hello/morpheus-board-middle/README.md

Hello Morpheus Middle board Repository
===
