hello/morpheus-board-middle/Morpheus_middle/54mm Board.DXF

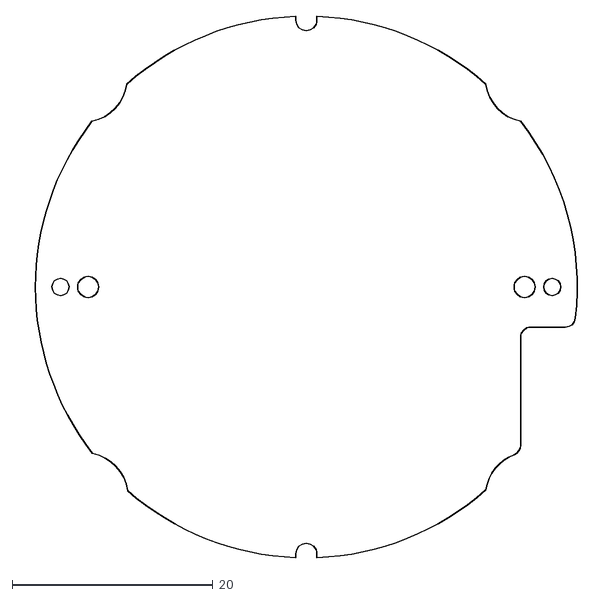
[picture p1: CAD file, 2014-11-20]
Morpheus_middle/54mm Board.DXF
56.5 x 54.0
