hello/morpheus-board-middle/Morpheus_middle/905-00004.DXF

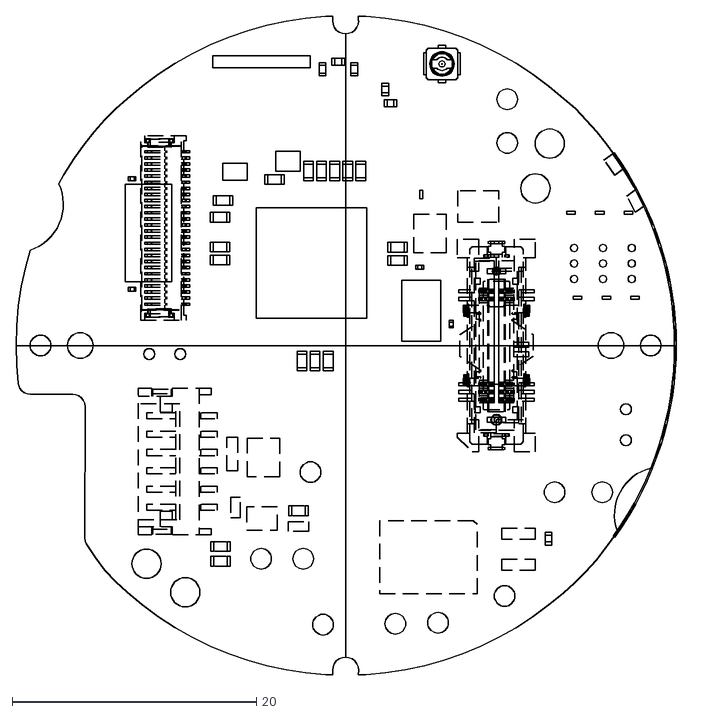
[picture p2: CAD file, 2014-11-20]
Morpheus_middle/905-00004.DXF
55.8 x 54.0
