hello/morpheus-board-middle/(list of files, cad)

Other CAD files:
Morpheus_middle/905-00004-04-DVTd.DWG
Morpheus_middle/Morpheus_middle.DWG
