hello/morpheus-board-middle/Release Files/Morpheus_middle_PVT_release_candidate_123014.PDF

IF CC3200 is changed to operate off of wide input voltage range,
the 1V8 tie needs to change to VBAT

to Program Boot Flash

Cross Connect UART
(To Nordic)
Analog Input from Dust Sensor

Nordic SPI Chip Select

interrupt from Nordic
interrupt from mid-board RTC

Digital Output to Dust Sensor
I2C Sensors
from I2S Codec
Nordic SPI CLK

CC_3200_PIN18
pin 18 is not usable as GPIO

WLAN_XTALM

TITLE M4F_MCU | REV DVT

DaTE | DRaWN BY D. Fusi | SHEET 1 OF 7


to the bottom board H1

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

OE is tied high. Provisions have been added to
tie it to nRESET in case the part doesn't come
up properly (small note in the datasheet p.2)


Power scheme only for reference

VIN_IO2 54

VDD_ANA2 | VDD_ANA2 47 VDD_ANA1 48

VDD_RAM | VDD_PA_IN VDD_RAM 49 VDD_DCDC_ANA | 33

VDD_PLL 24

VIN_DCDC_DIG 44

All filtering caps as per TI's recomendations

Route ground traces for C15, C16 and C17 to single vias on the EPAD. Isolate them from pours in inner layers


level shifter from 4V to 1.8V

Connector for Sharp dust sensor GP2Y1010AU0F

JST_S6B-ZR-SM4A-TF (LF)(SN)(P)

As on the GP2Y1010 datasheet


TI wants 17 and R18 to be installed but we've always been good without

Datasheet is unclear, so for now we pull reset high and WP low


R9 and R26 will be inductors if needed. C46 and C47 DNP for now

Murata 0201 GJM0335C1ER20WB01
Murata 0402 GJM1555C1H100GB01D
Murata 0402 LQP15MN1N0B02
GJM series is better than GRM for RF


CLK needs a dedicated level shifter beacuse of speed

CMD and DAT shifter on dedicated level shifter

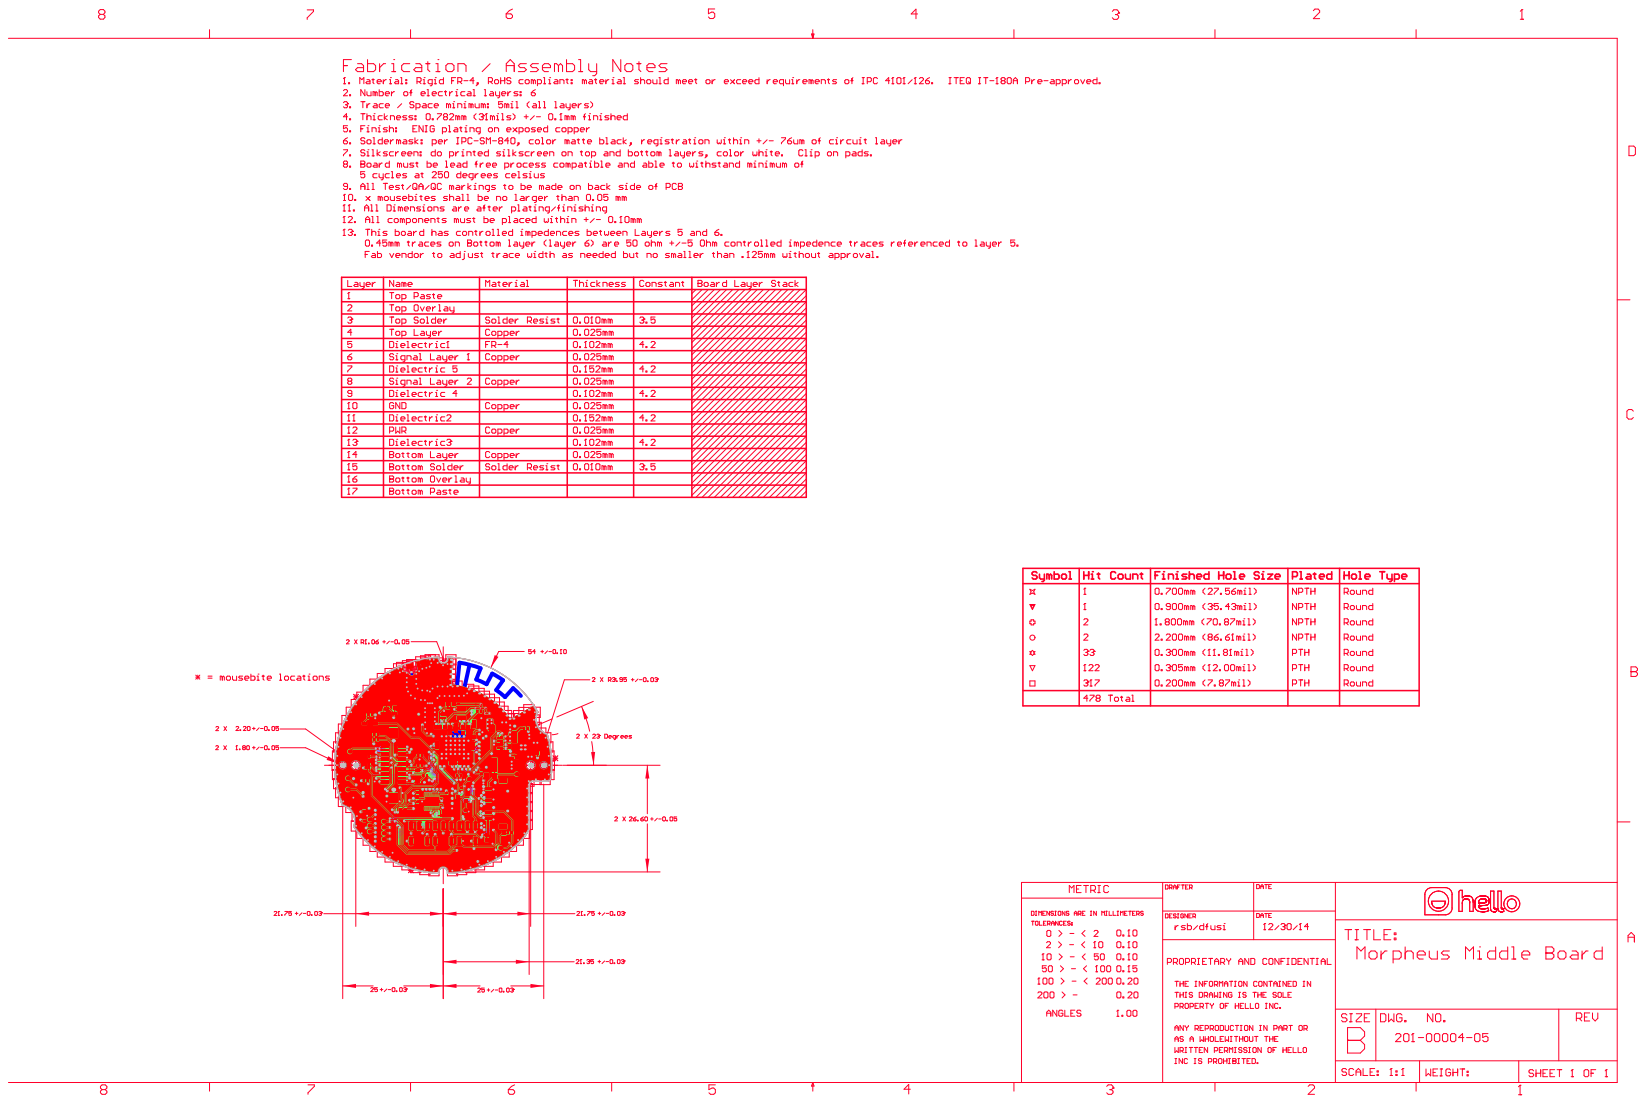
[picture p13: page 8]

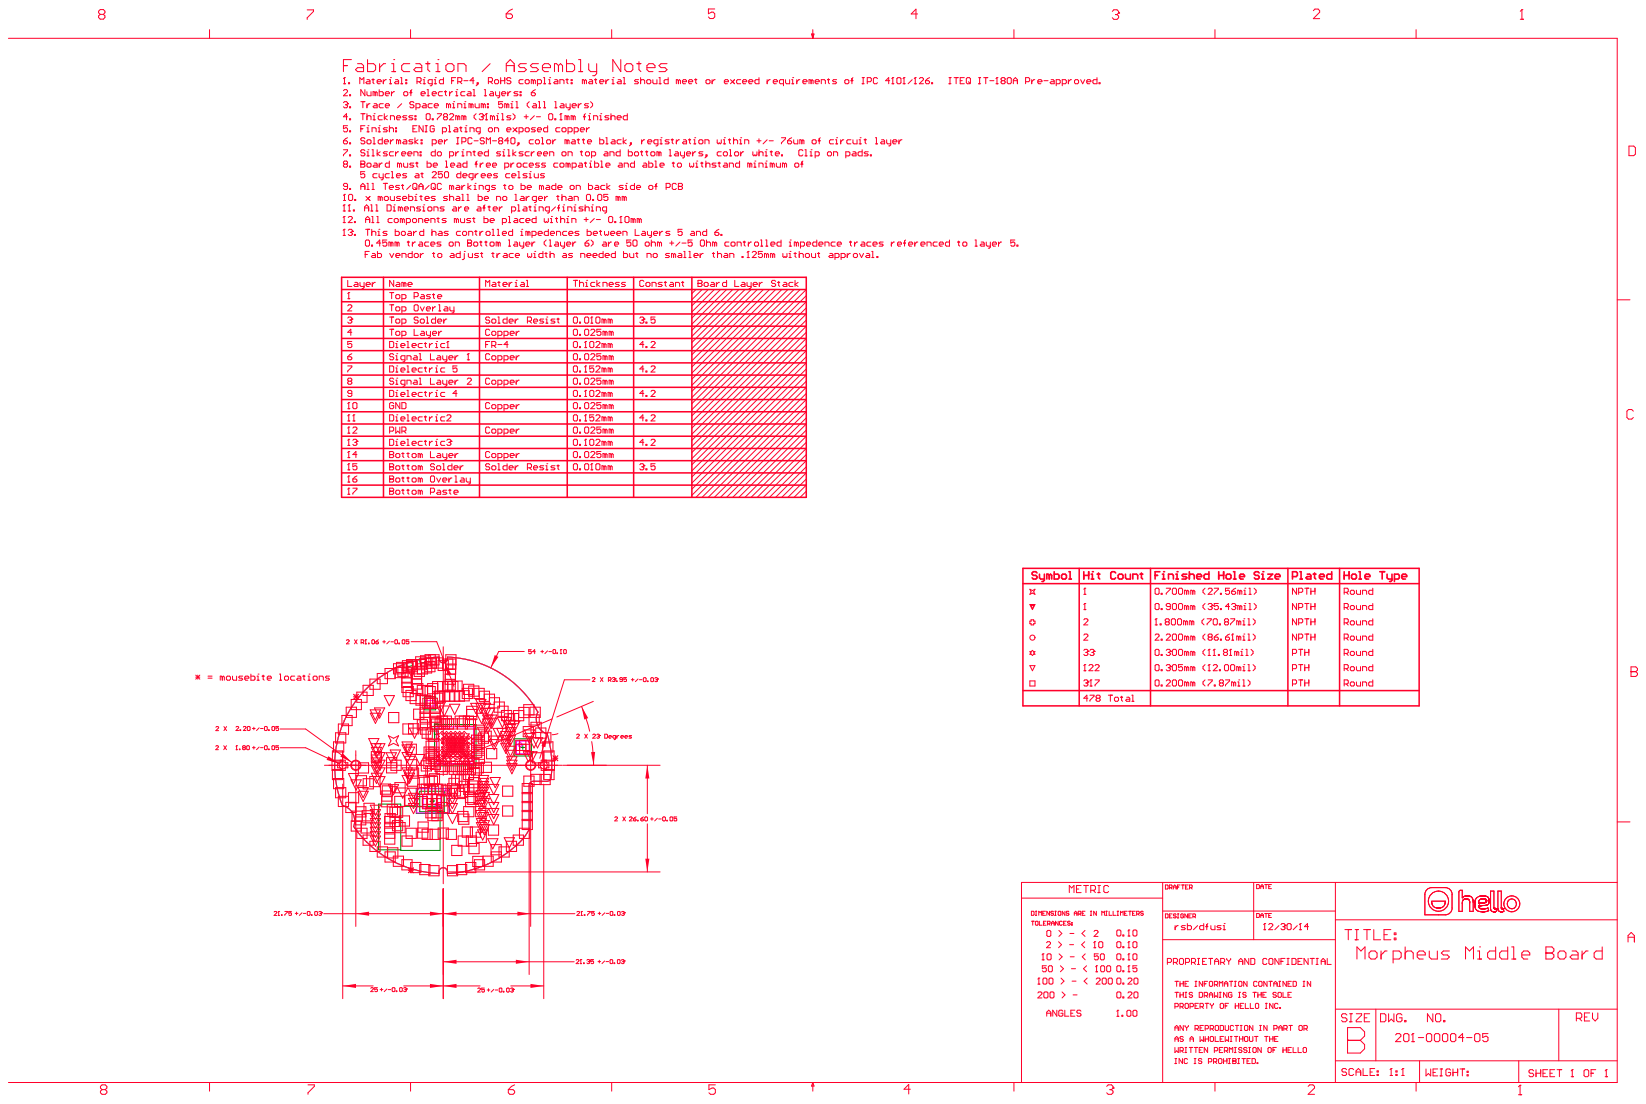
[picture p14: page 9]

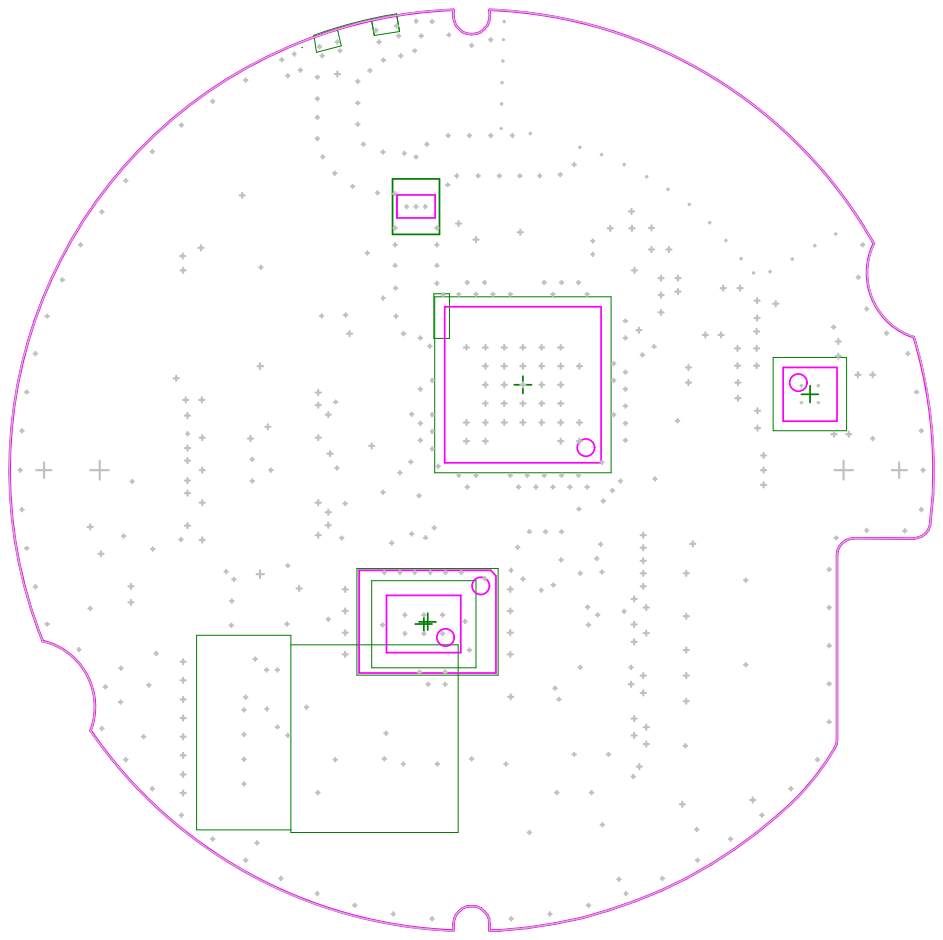
[picture p15: page 10]
