hello/morpheus-board-middle/Morpheus_middle/Morpheus_middle.PDF

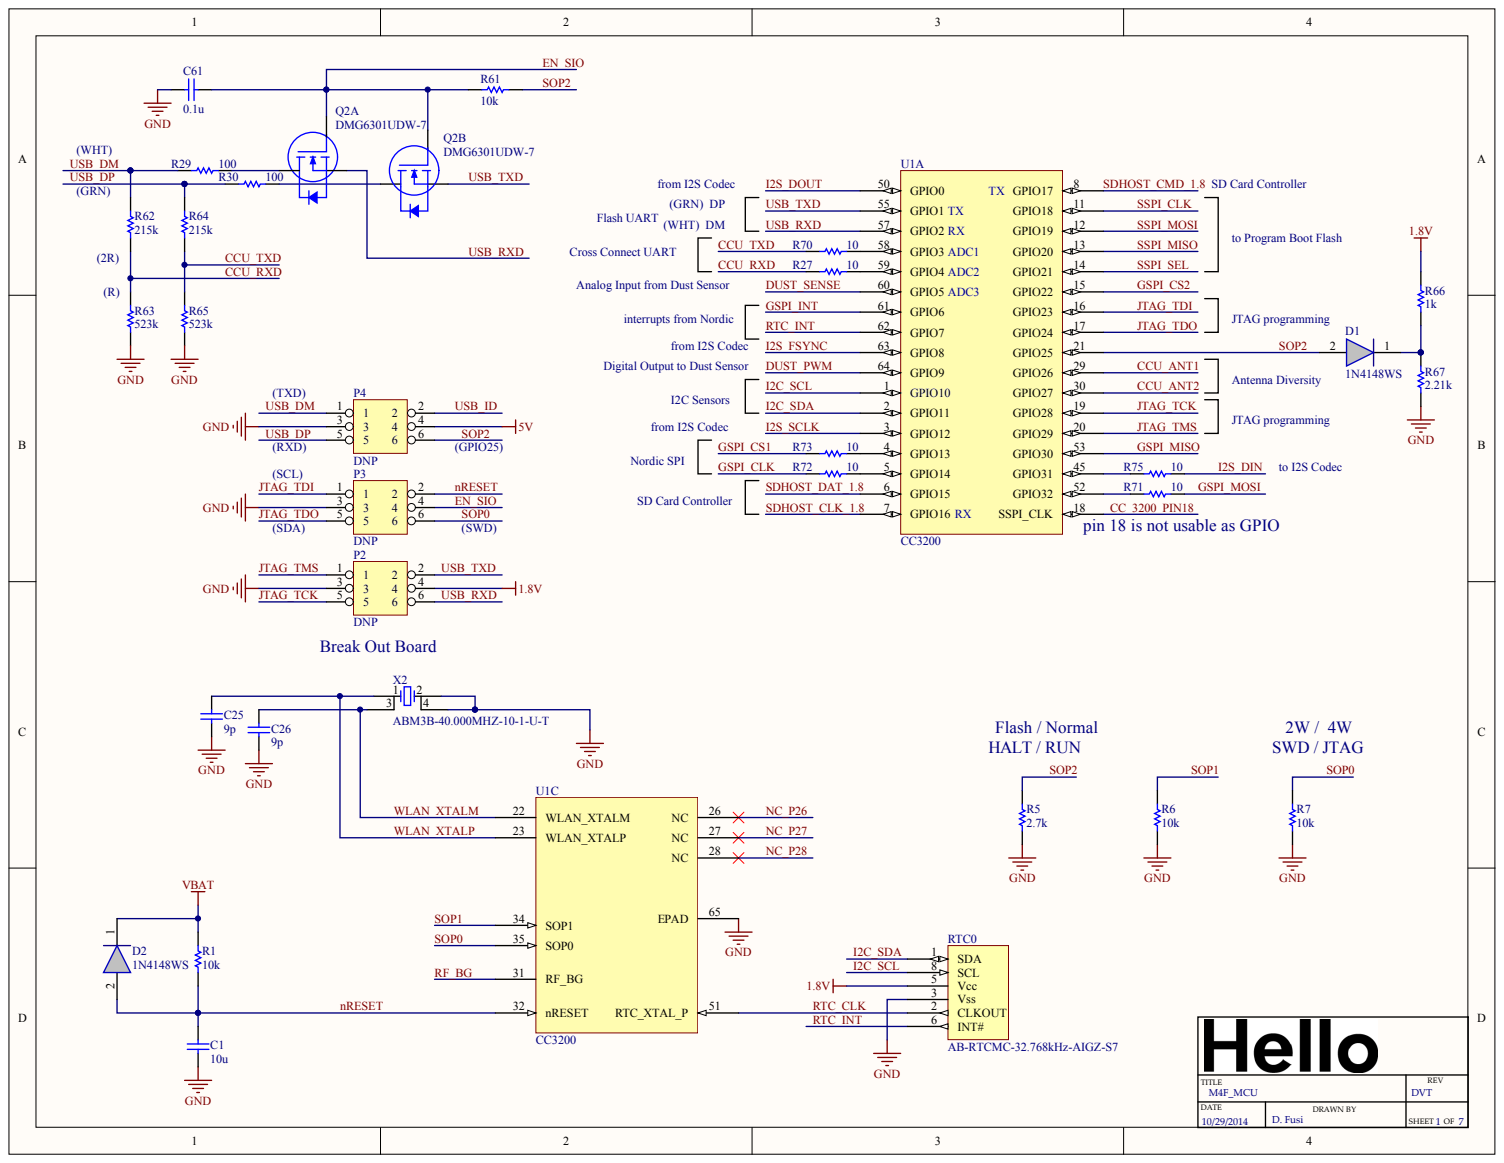
[picture p27: page 1]

to Program Boot Flash

Analog Input from Dust Sensor

Digital Output to Dust Sensor

CC_3200_PIN18
pin 18 is not usable as GPIO

WLAN_XTALM

TITLE M4F_MCU | REV DVT

DATE | DRAWN BY D. Fusi | SHEET 1 OF 7

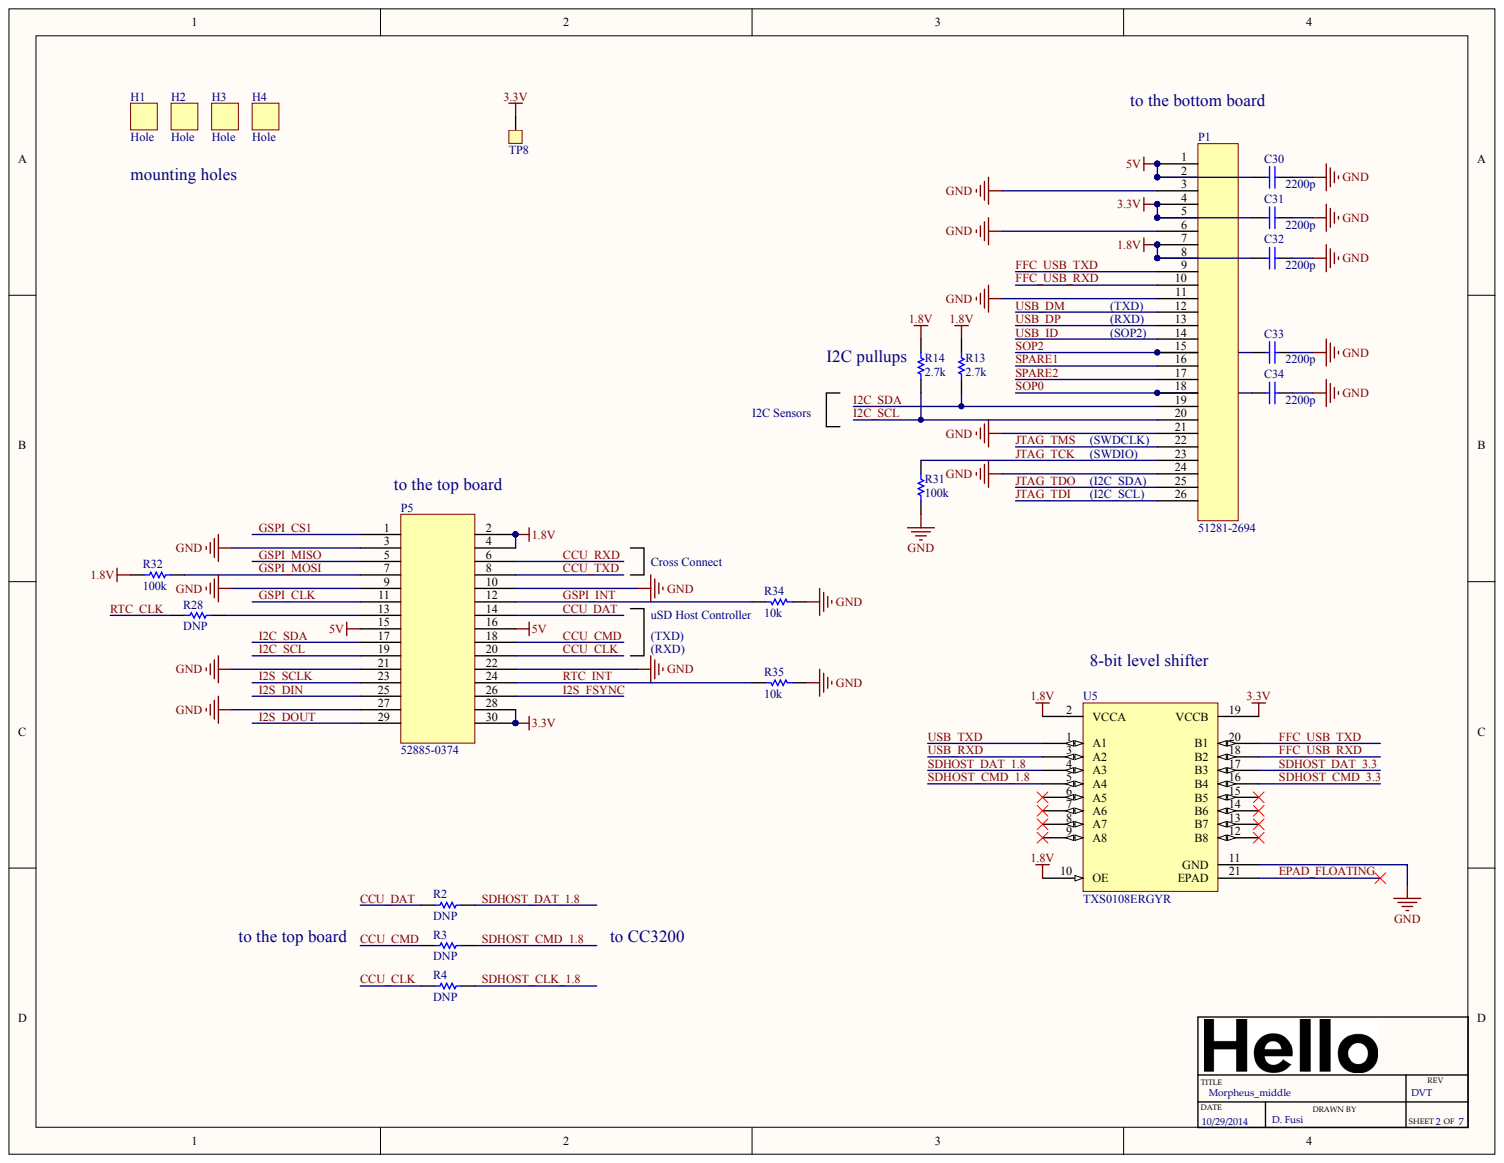
[picture p28: page 2]

to the bottom board H1

to the top board

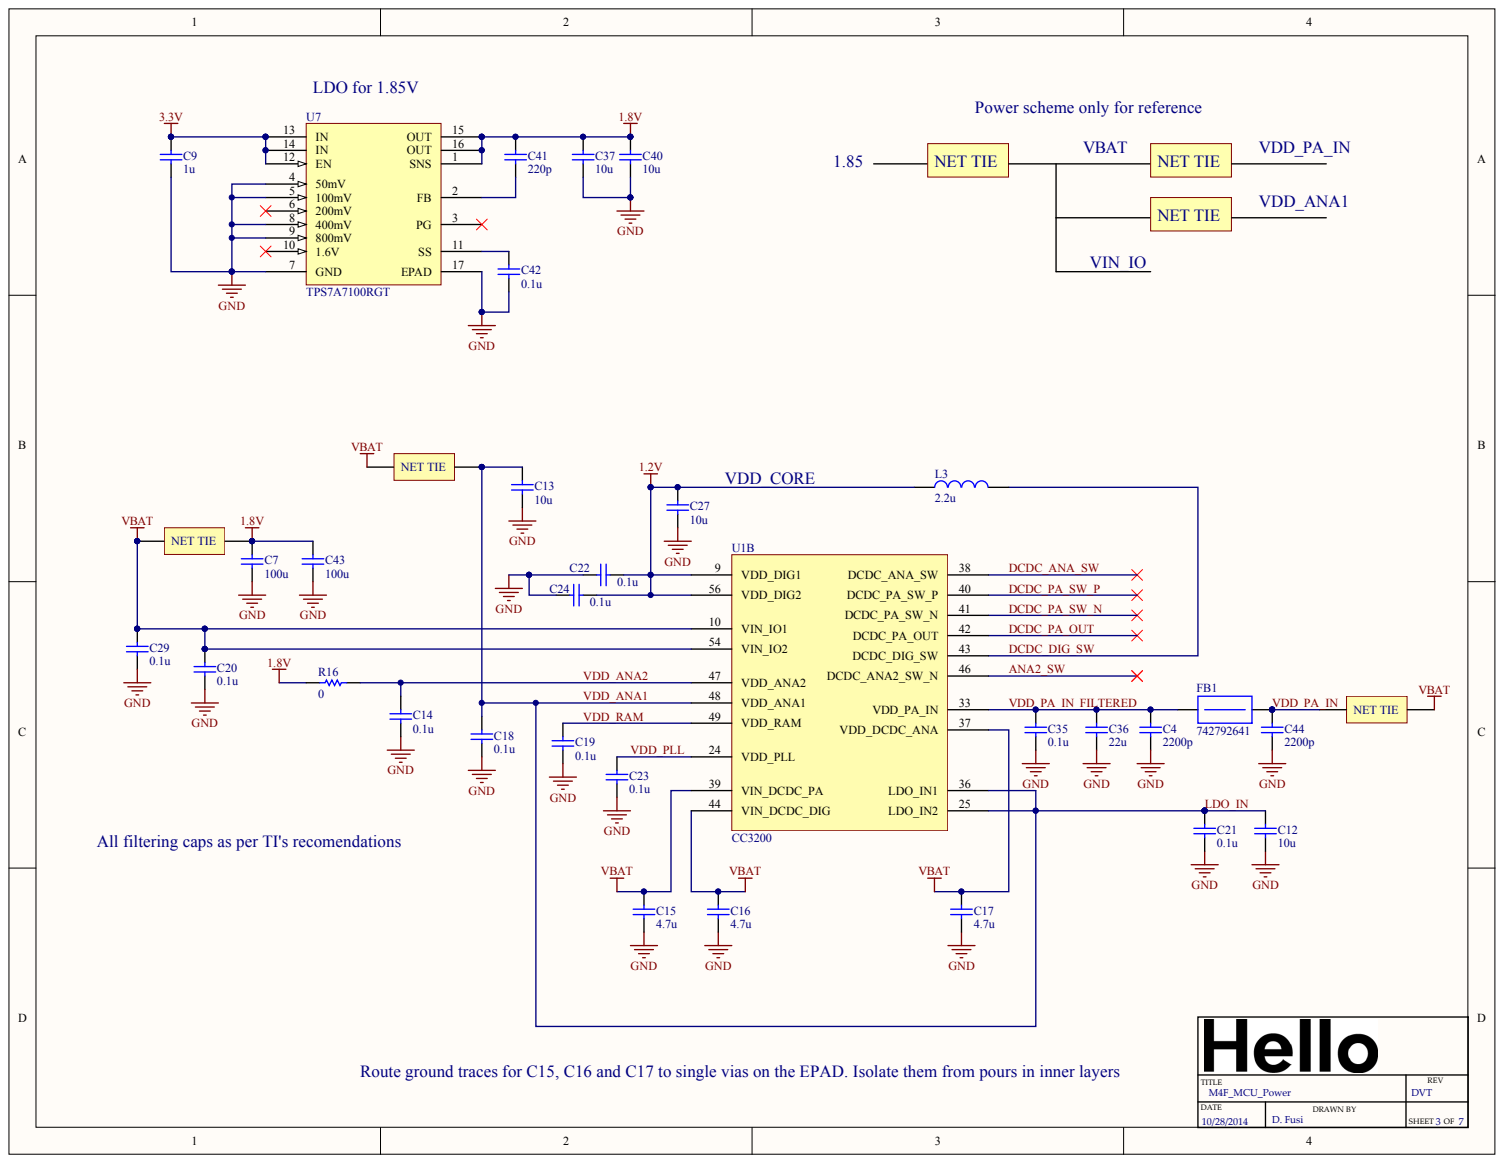
[picture p29: page 3]

Power scheme only for reference

VIN_IO2 54

VDD_ANA2 | VDD_ANA2 47 VDD_ANA1 48

VDD_RAM | VDD_PA_IN VDD_RAM 49 VDD_DCDC_ANA | 33

VDD_PLL 24

VIN_DCDC_DIG 44

All filtering caps as per TI's recomendations

Route ground traces for C15, C16 and C17 to single vias on the EPAD. Isolate them from pours in inner layers

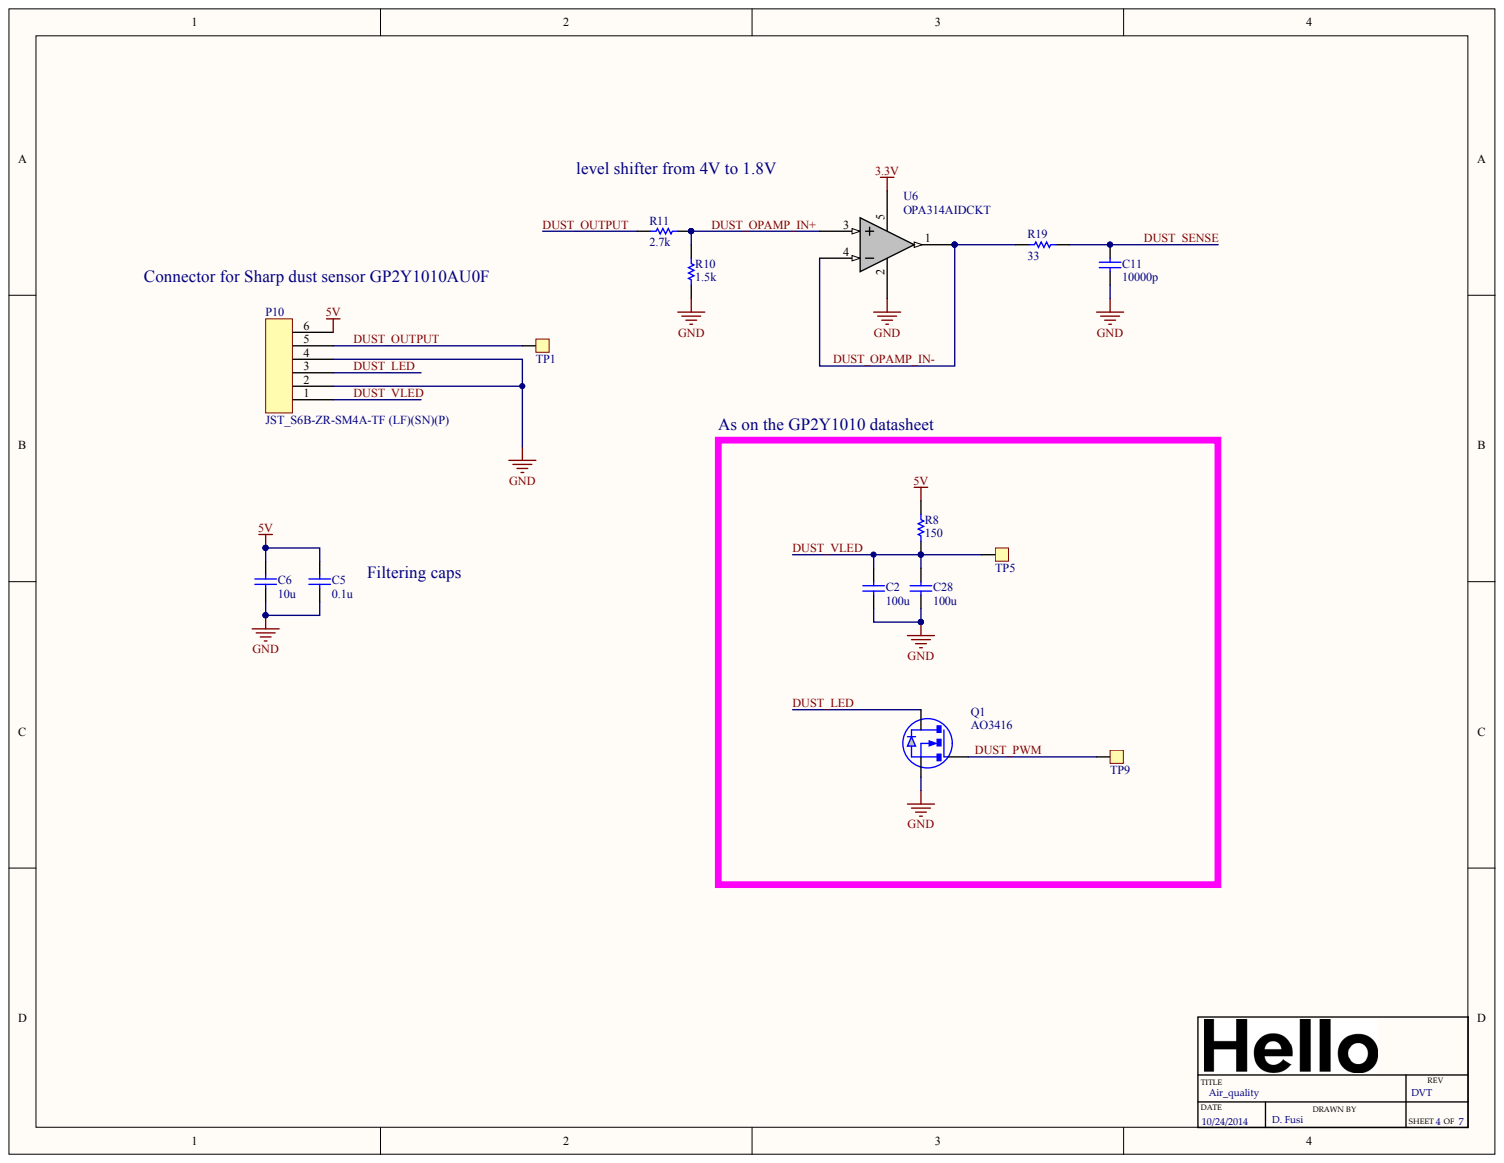
[picture p30: page 4]

level shifter from 4V to 1.8V

Connector for Sharp dust sensor GP2Y1010AU0F

JST_S6B-ZR-SM4A-TF (LF)(SN)(P)

As on the GP2Y1010 datasheet

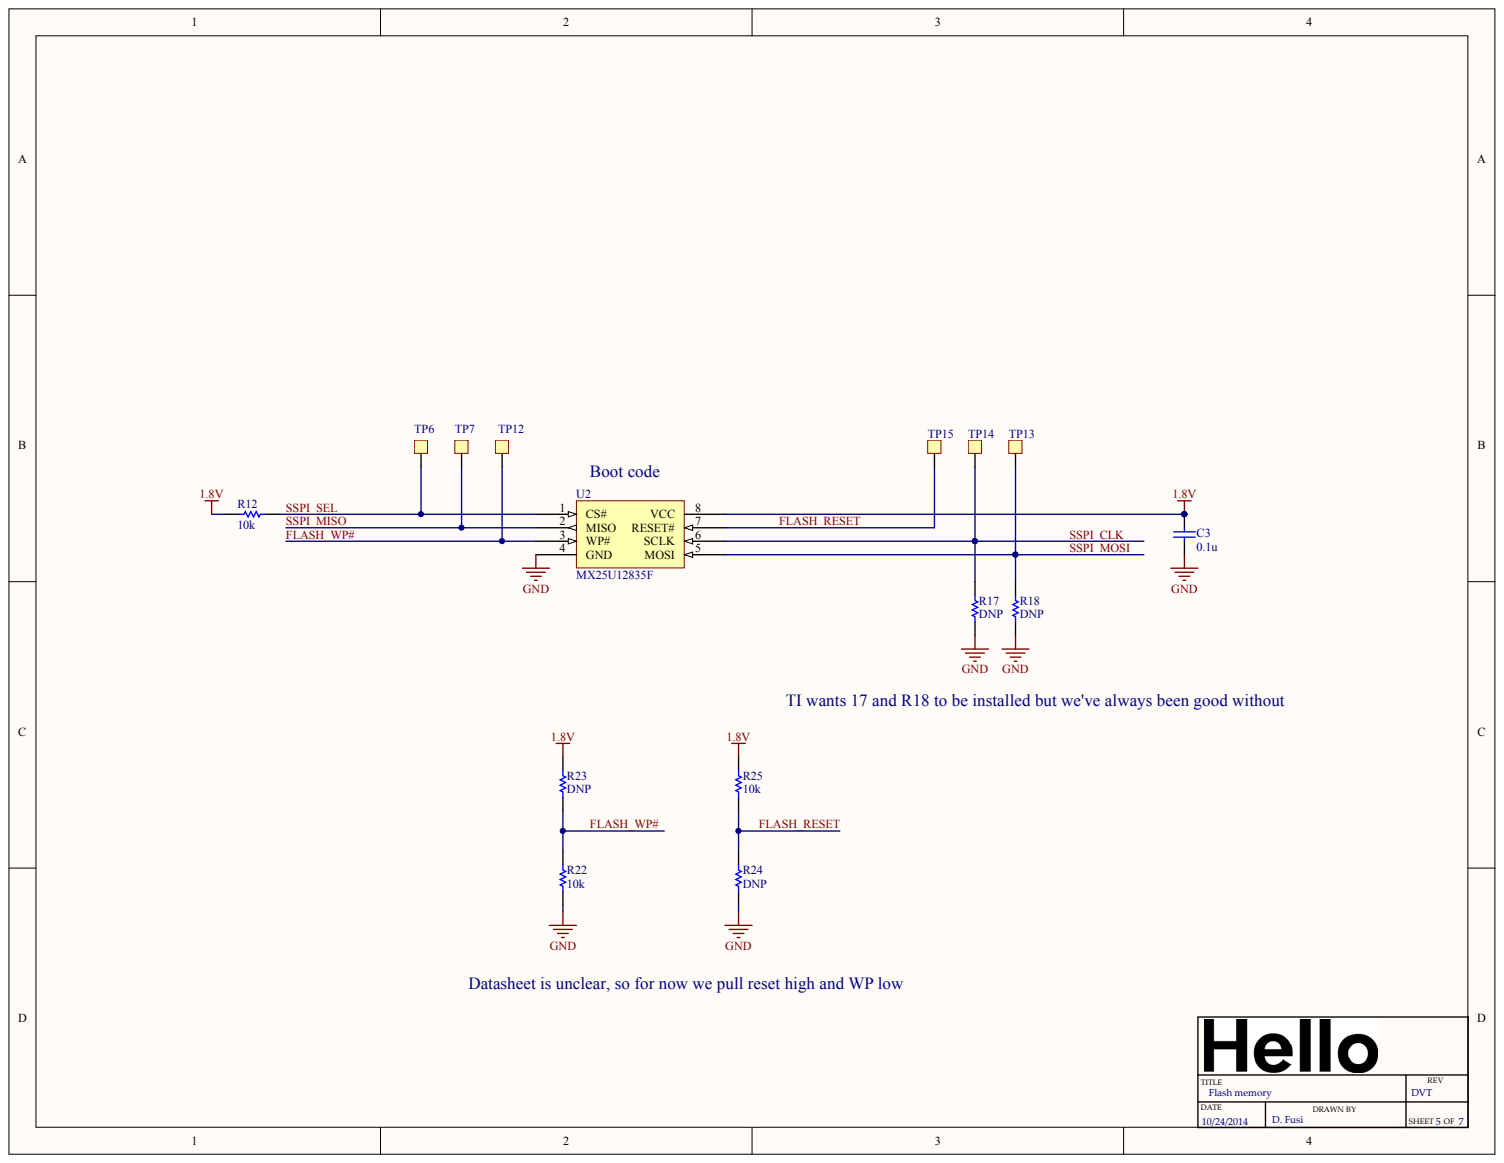
[picture p31: page 5]

TI wants 17 and R18 to be installed but we've always been good without

Datasheet is unclear, so for now we pull reset high and WP low

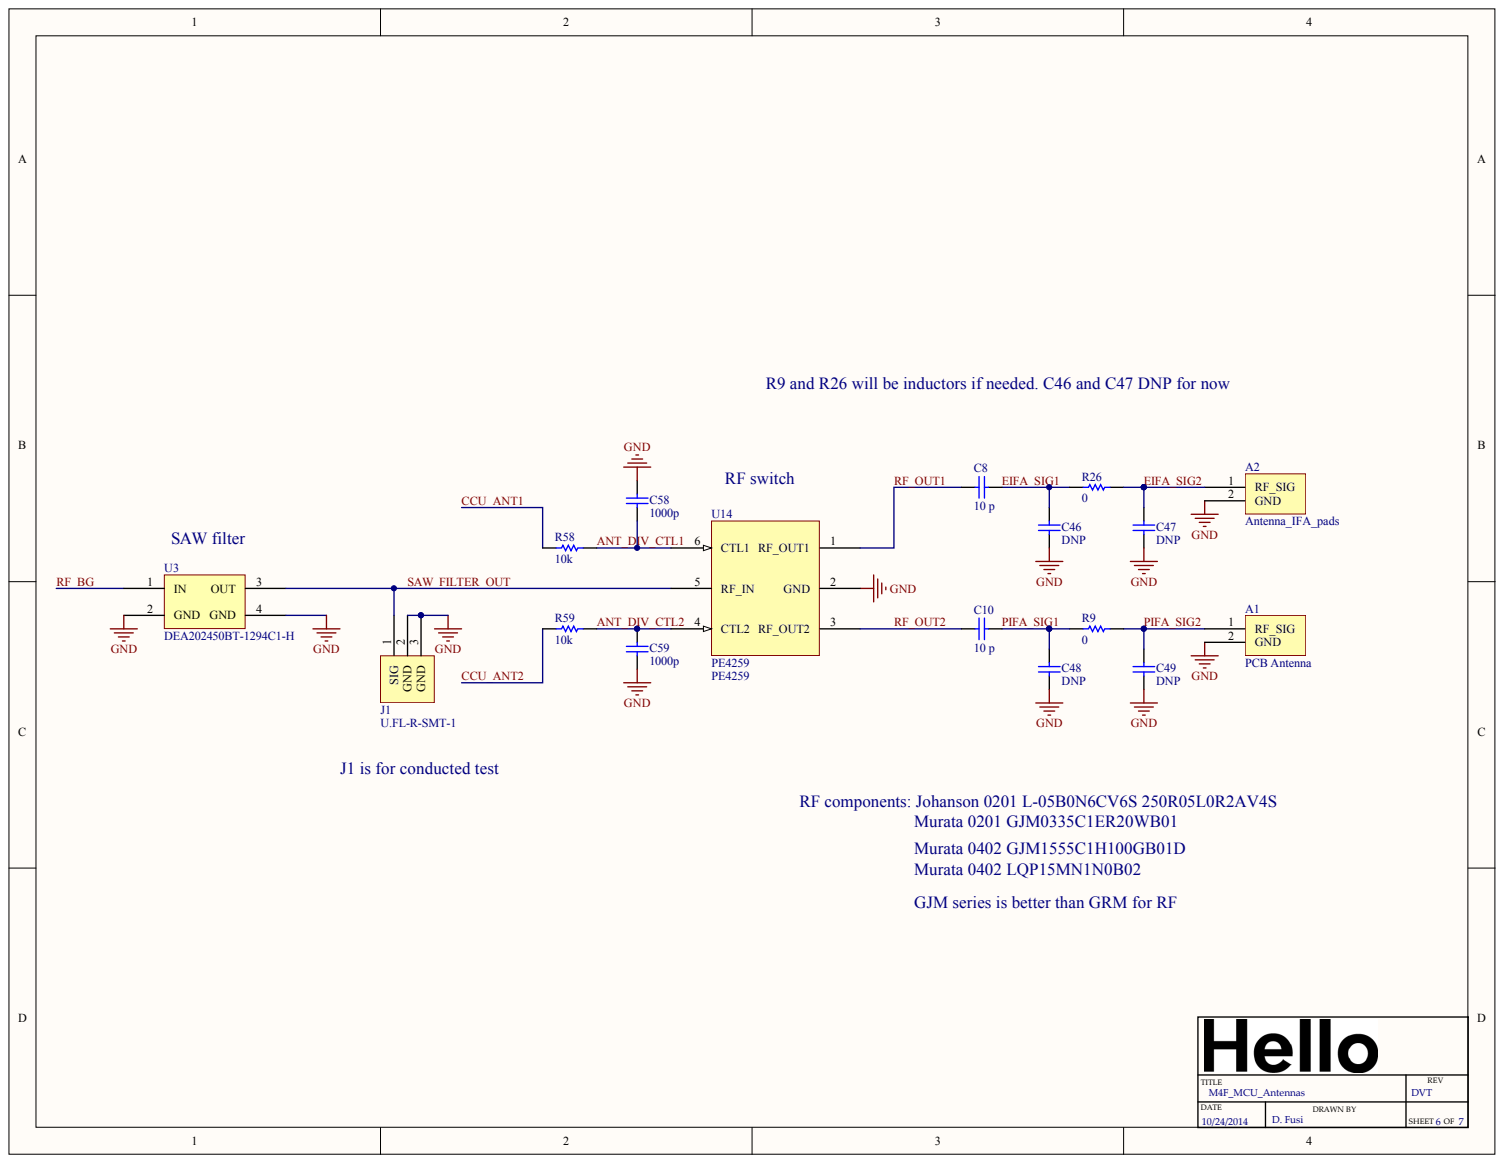
[picture p32: page 6]

R9 and R26 will be inductors if needed. C46 and C47 DNP for now

J1 is for conducted test

GJM series is better than GRM for RF

TITLE M4F_MCU_A nten nas

D ATE | DRAWN BY D . Fusi | S HEET 6 OF


CLK needs a dedicated level shifter beacuse of speed

CMD and DAT shifter on dedicated level shifter
