hello/morpheus-board-middle/Morpheus_middle/Morpheus_middle_DVT_release_candidate_111714.PDF

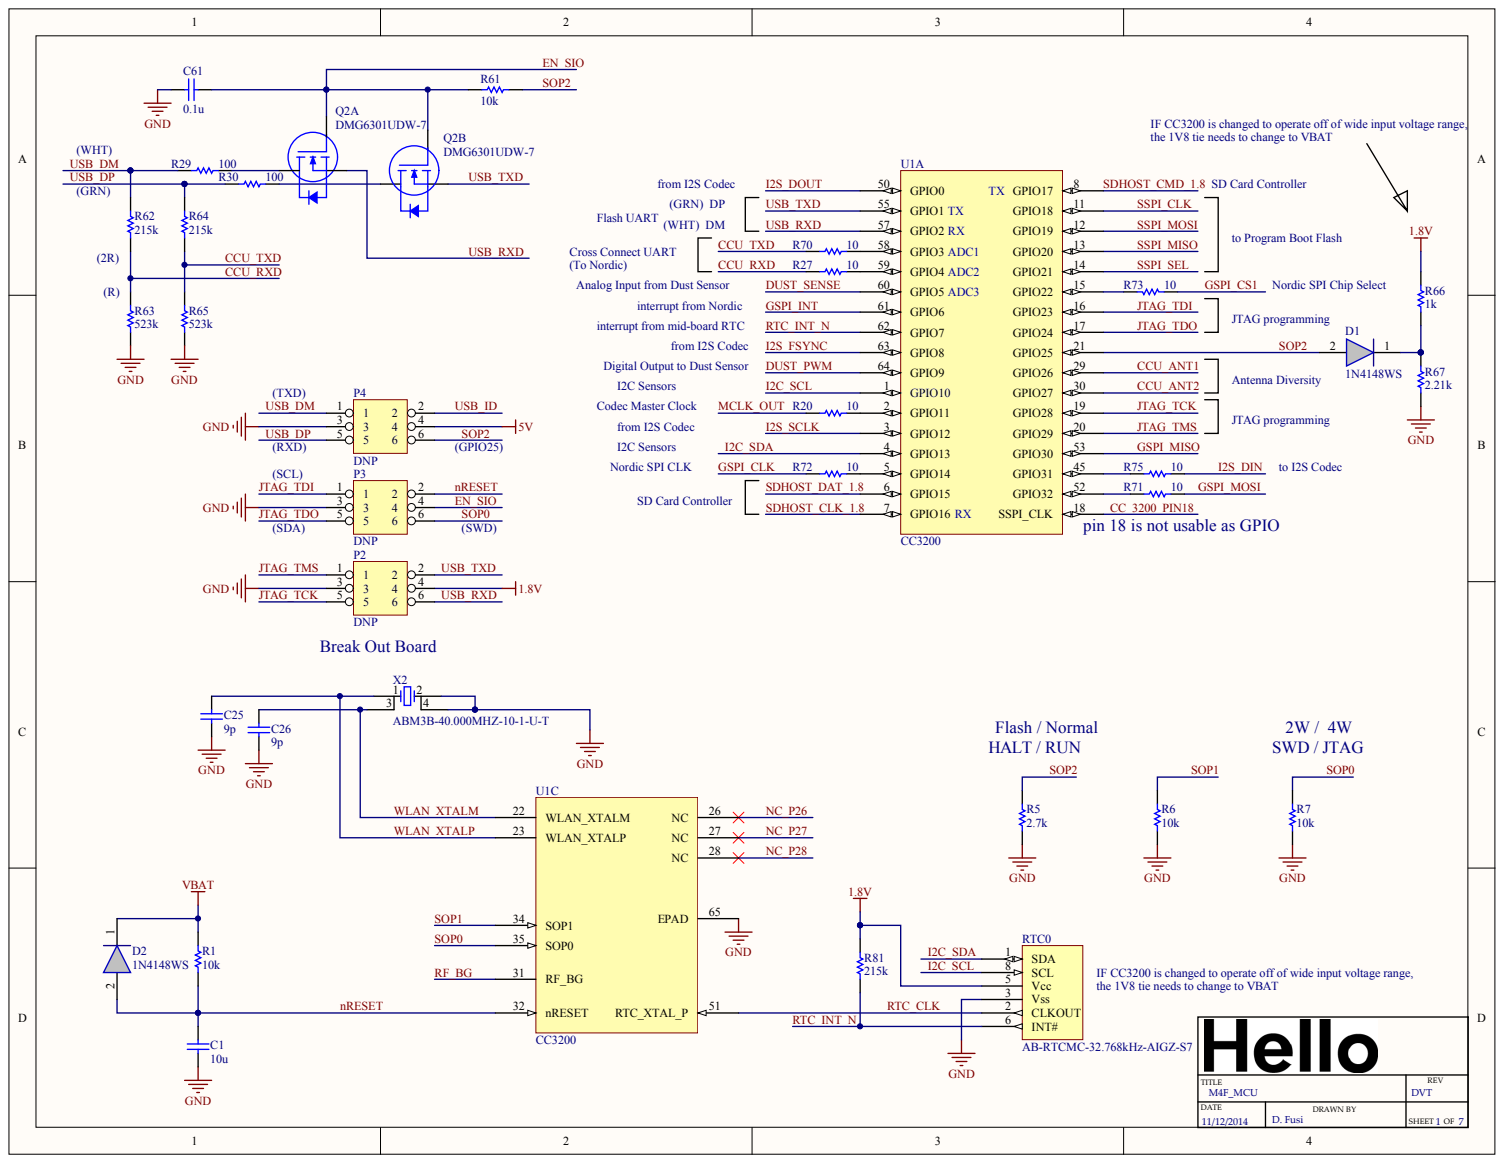
[picture p33: page 1]

IF CC3200 is changed to operate off of wide input voltage range,
the 1V8 tie needs to change to VBAT

Cross Connect UART
(To Nordic)
Analog Input from Dust Sensor

to Program Boot Flash

Nordic SPI Chip Select

interrupt from mid-board RTC

Digital Output to Dust Sensor
I2C Sensors
from I2S Codec
Nordic SPI CLK

CC_3200_PIN18
pin 18 is not usable as GPIO

WLAN_XTALM

TITLE M4F_MCU | REV DVT

DATE | DRAWN BY D. Fusi | SHEET 1 OF 7

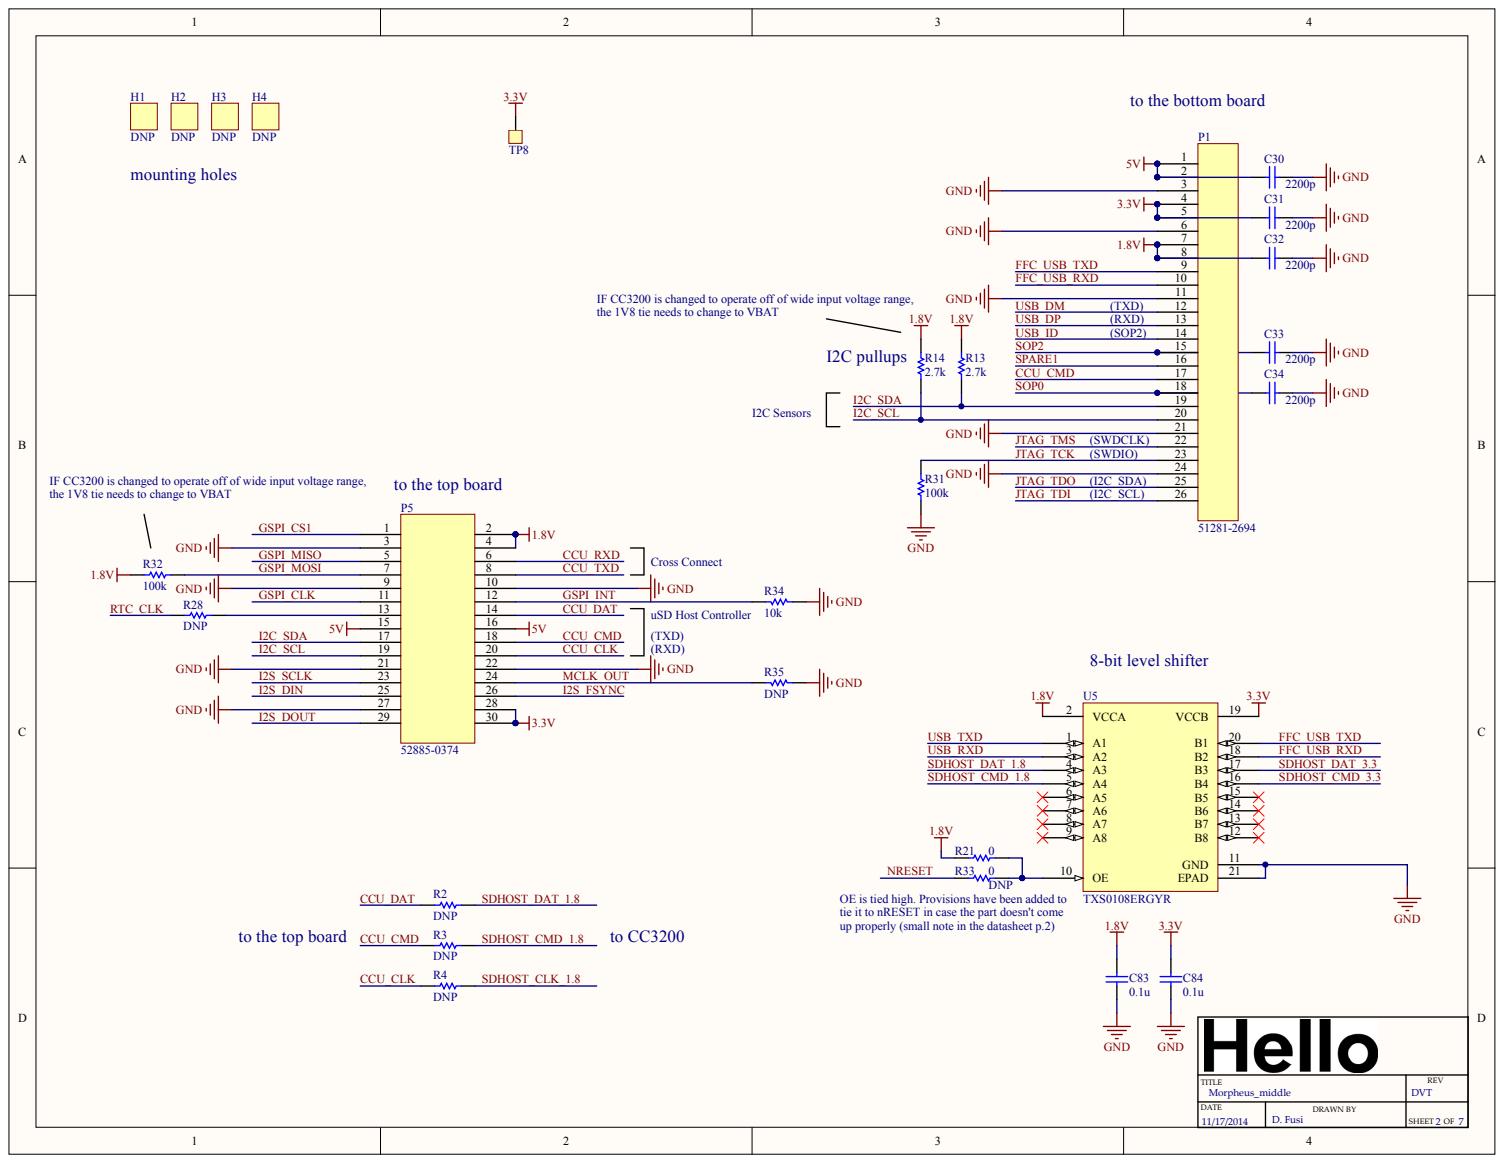
[picture p34: page 2]

to the bottom board H1

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

to the top board

OE is tied high. Provisions have been added to
tie it to nRESET in case the part doesn't come
up properly (small note in the datasheet p.2)

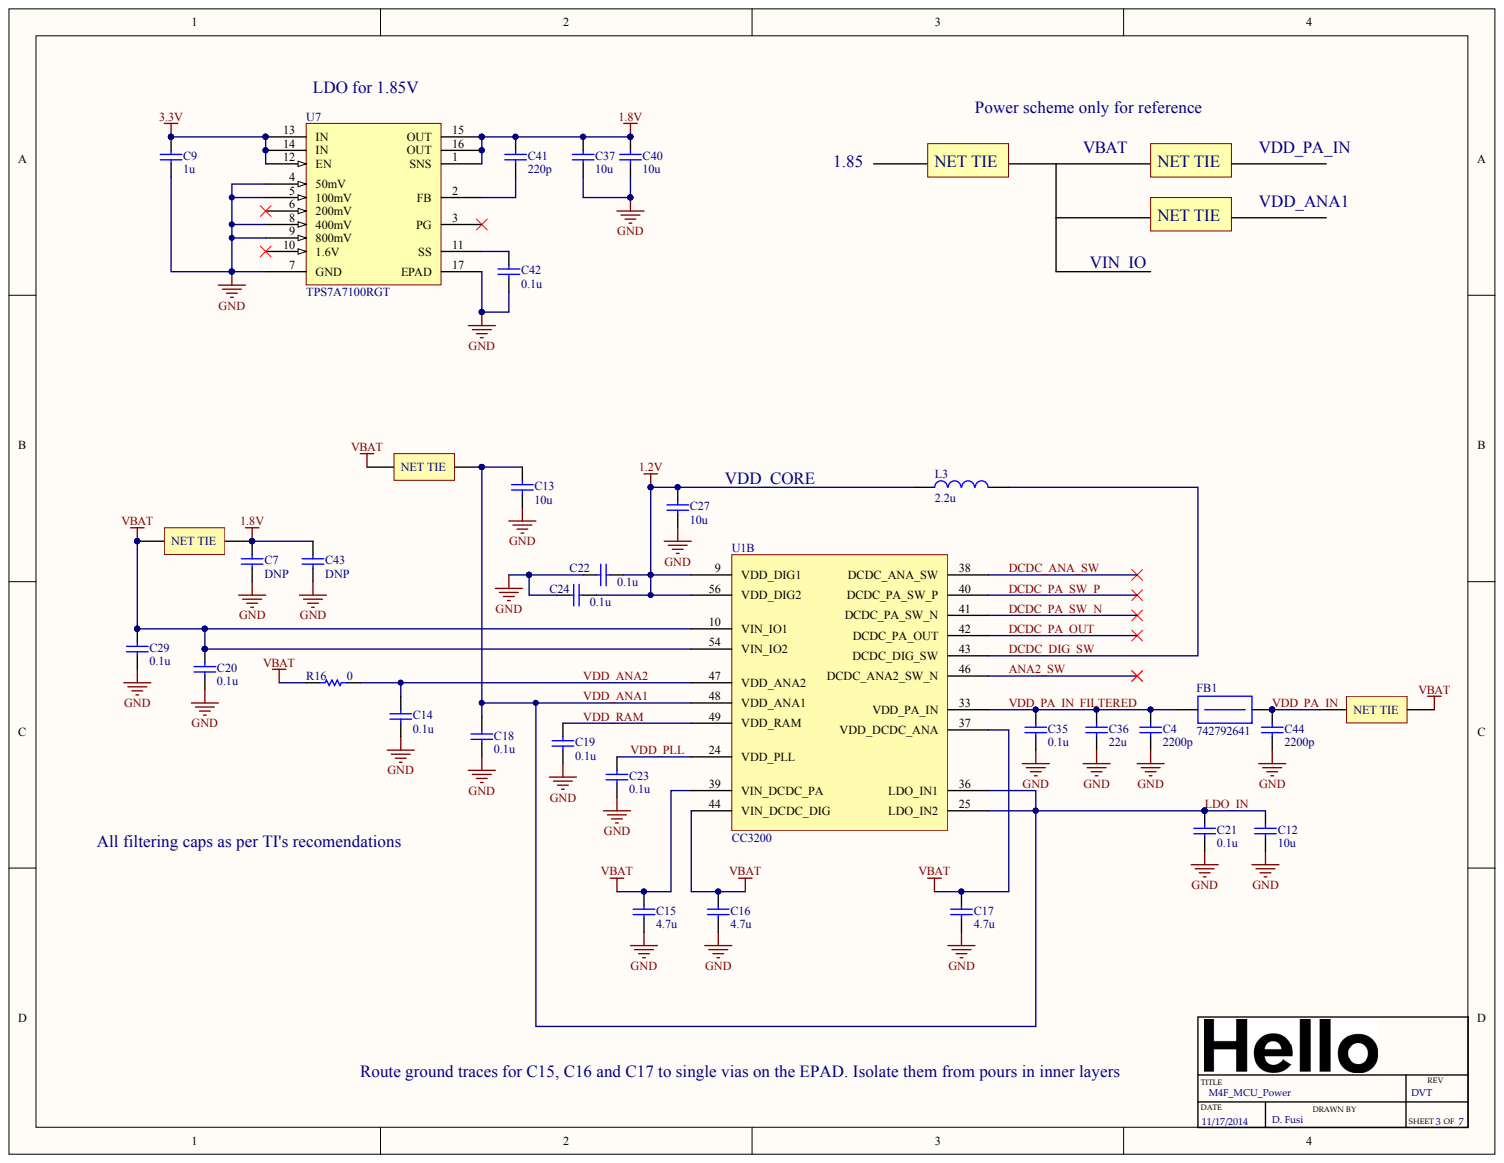
[picture p35: page 3]

Power scheme only for reference

VIN_IO2 54

VDD_ANA2 | VDD_ANA2 47 VDD_ANA1 48

VDD_RAM | VDD_PA_IN VDD_RAM 49 VDD_DCDC_ANA | 33

VDD_PLL 24

VIN_DCDC_DIG 44

All filtering caps as per TI's recomendations

Route ground traces for C15, C16 and C17 to single vias on the EPAD. Isolate them from pours in inner layers

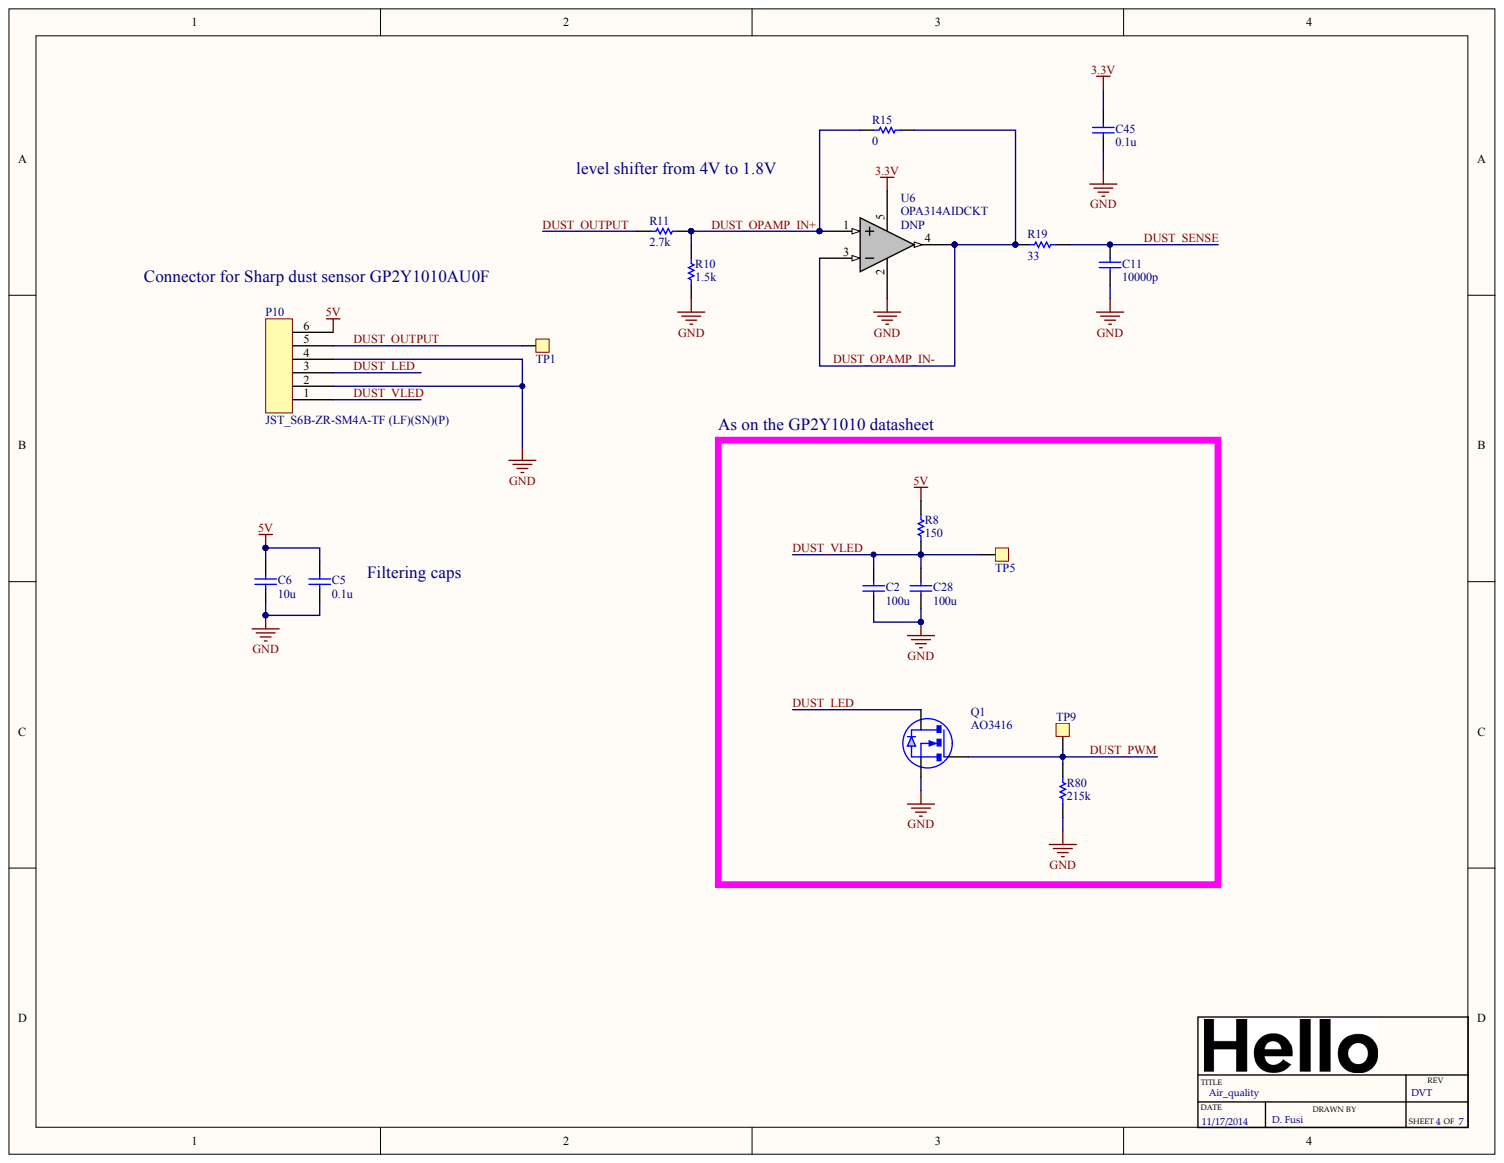
[picture p36: page 4]

level shifter from 4V to 1.8V

Connector for Sharp dust sensor GP2Y1010AU0F

JST_S6B-ZR-SM4A-TF (LF)(SN)(P)

As on the GP2Y1010 datasheet

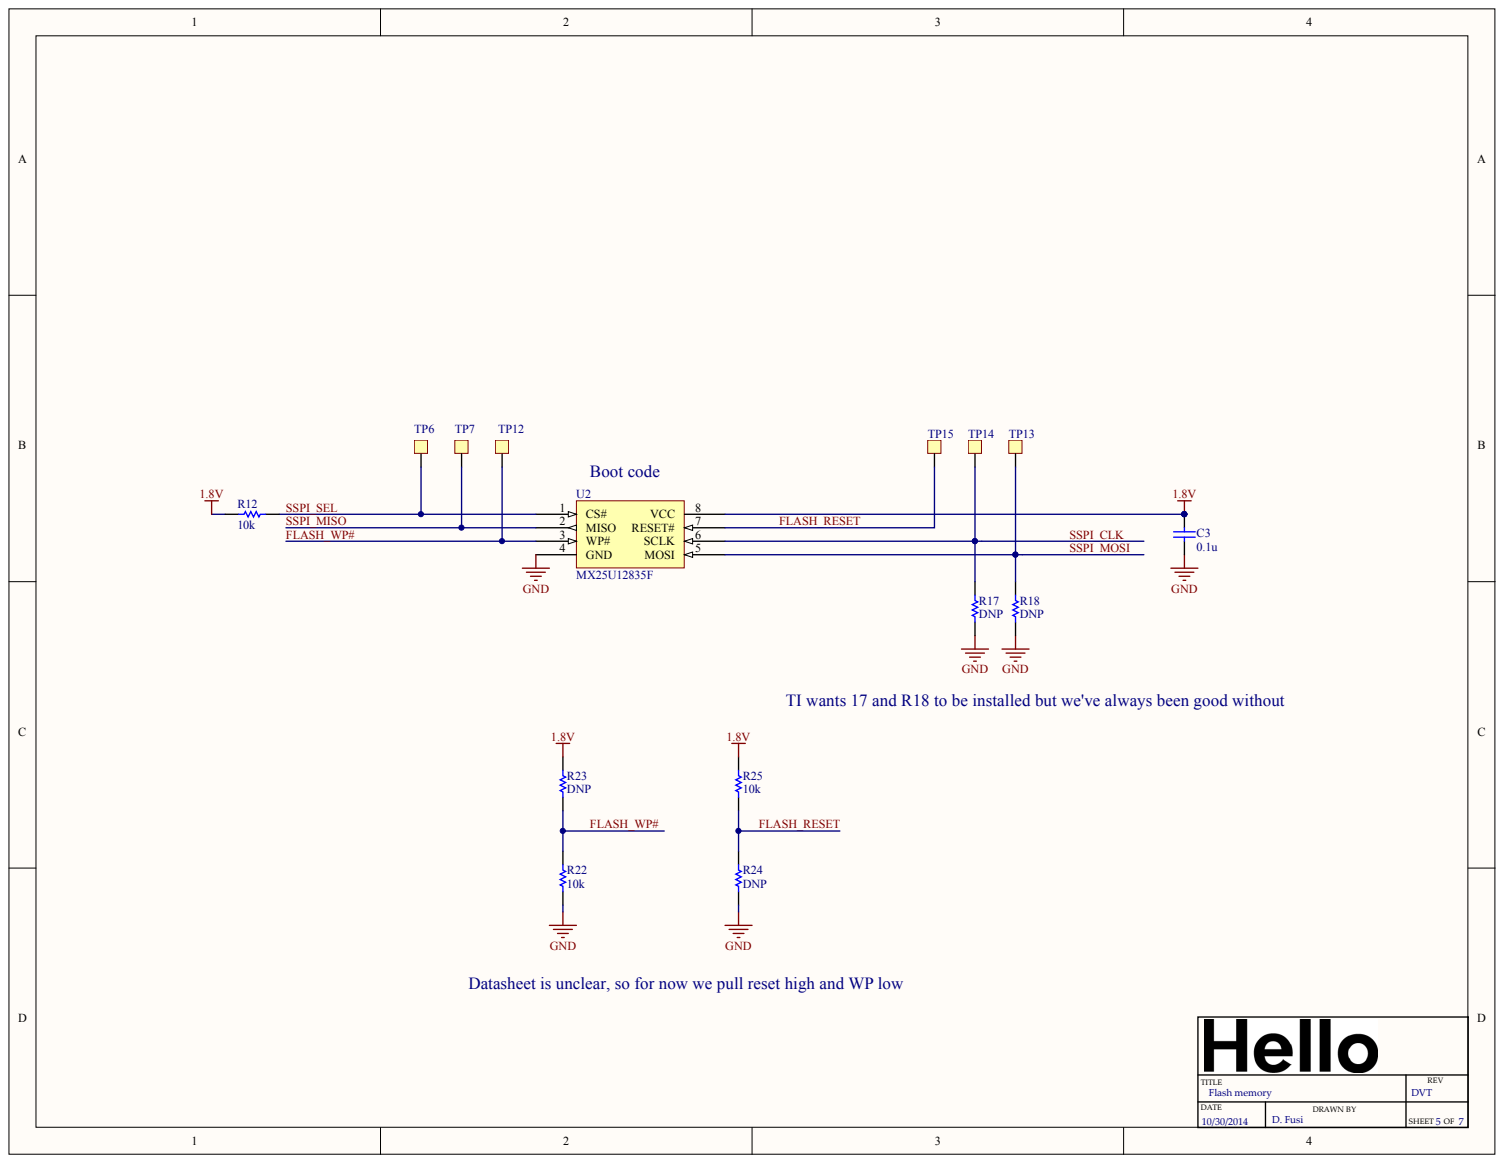
[picture p37: page 5]

TI wants 17 and R18 to be installed but we've always been good without

Datasheet is unclear, so for now we pull reset high and WP low

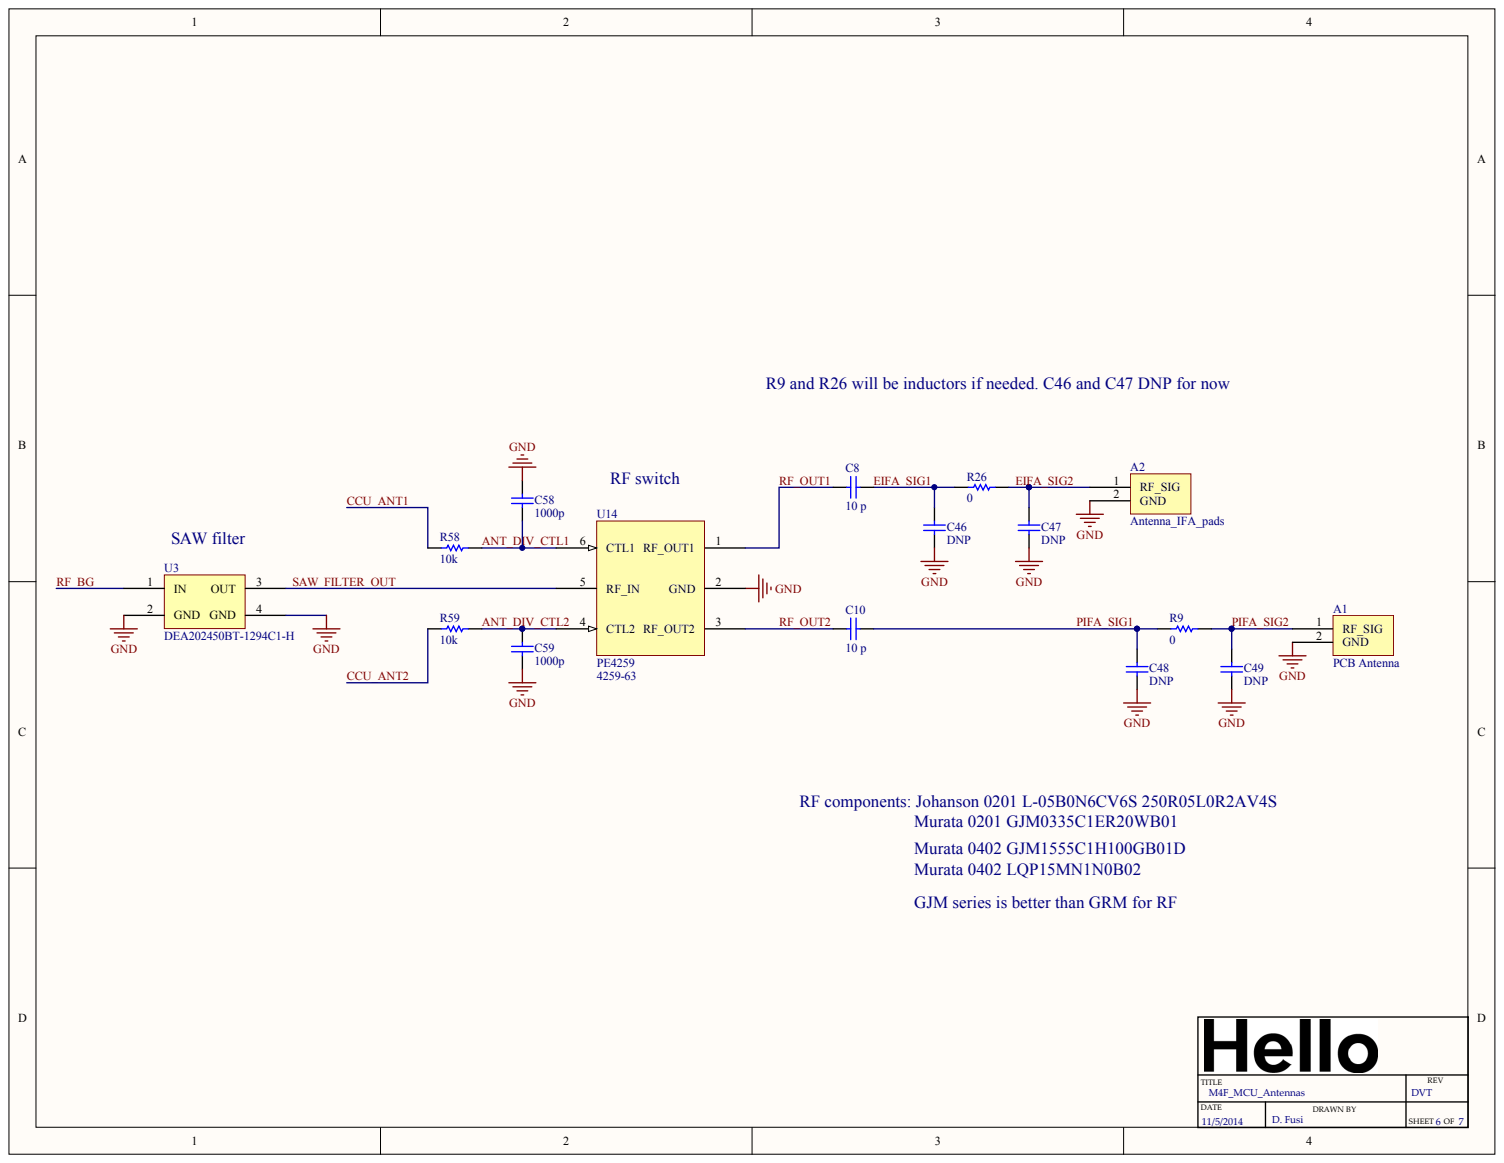
[picture p38: page 6]

R9 and R26 will be inductors if needed. C46 and C47 DNP for now

GJM series is better than GRM for RF

TITLE M4F_MCU_A nten nas

D ATE | DRAWN BY D . Fusi | S HEET 6 OF


CLK needs a dedicated level shifter beacuse of speed

CMD and DAT shifter on dedicated level shifter

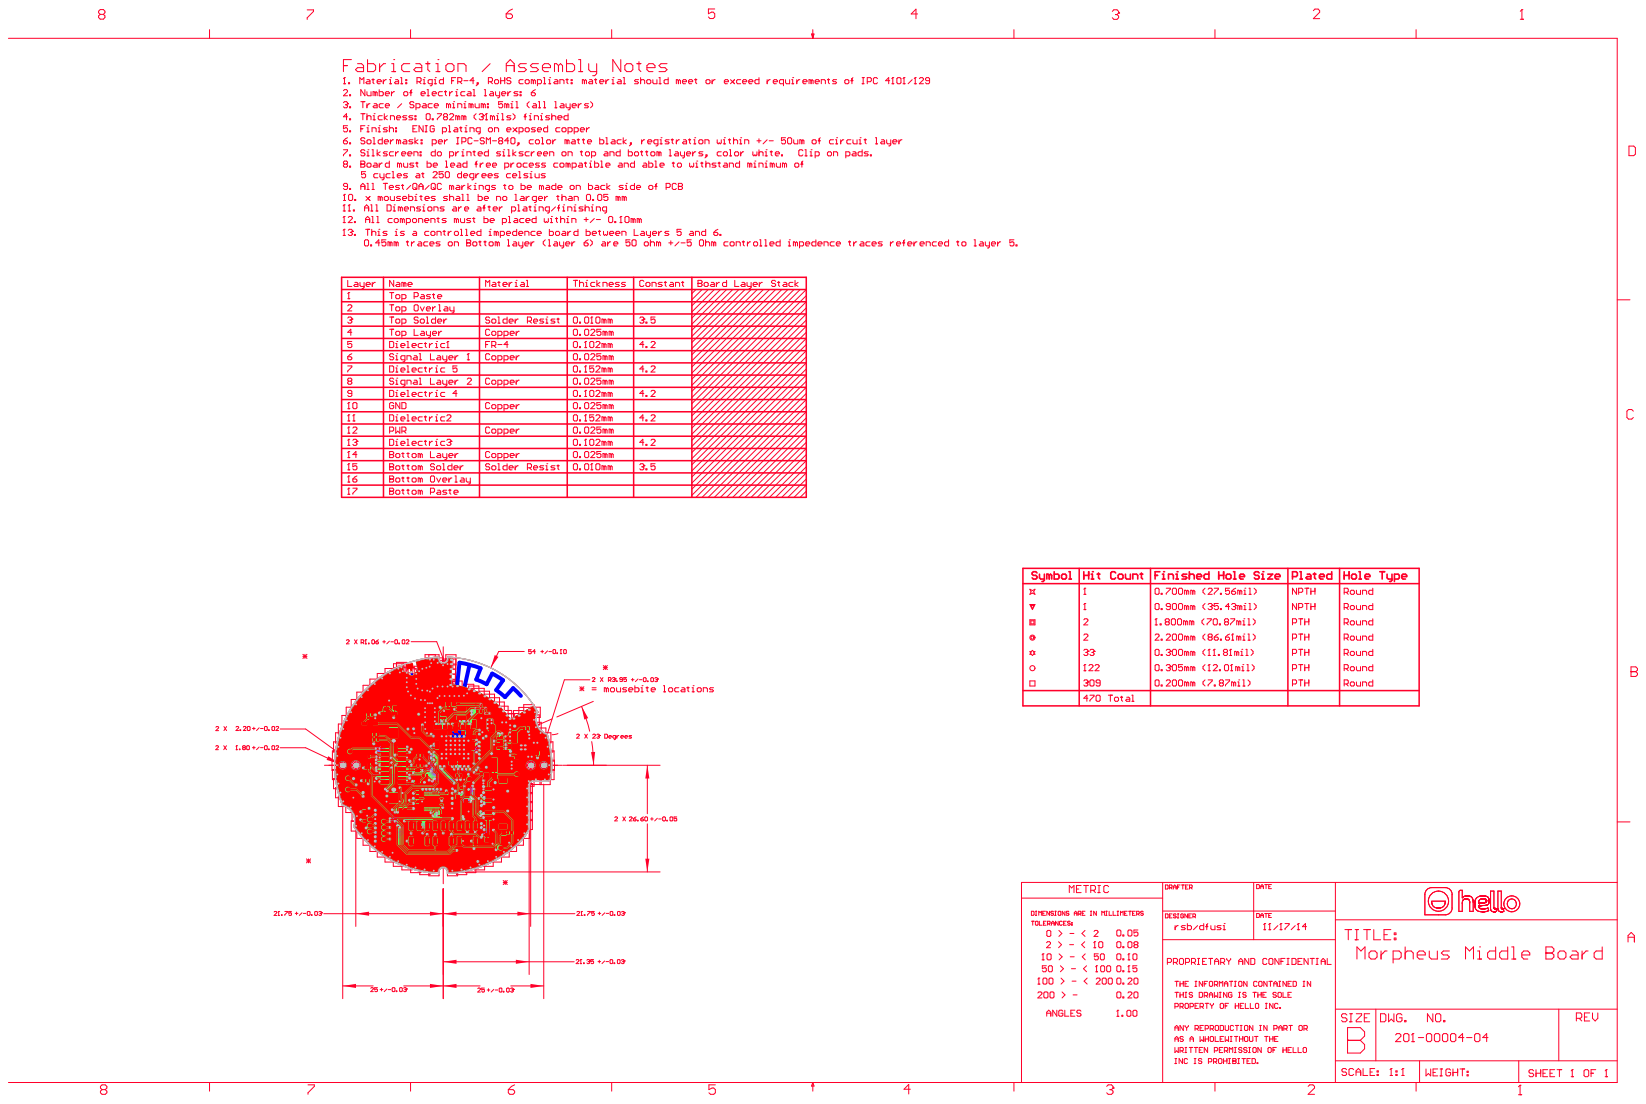
[picture p39: page 8]

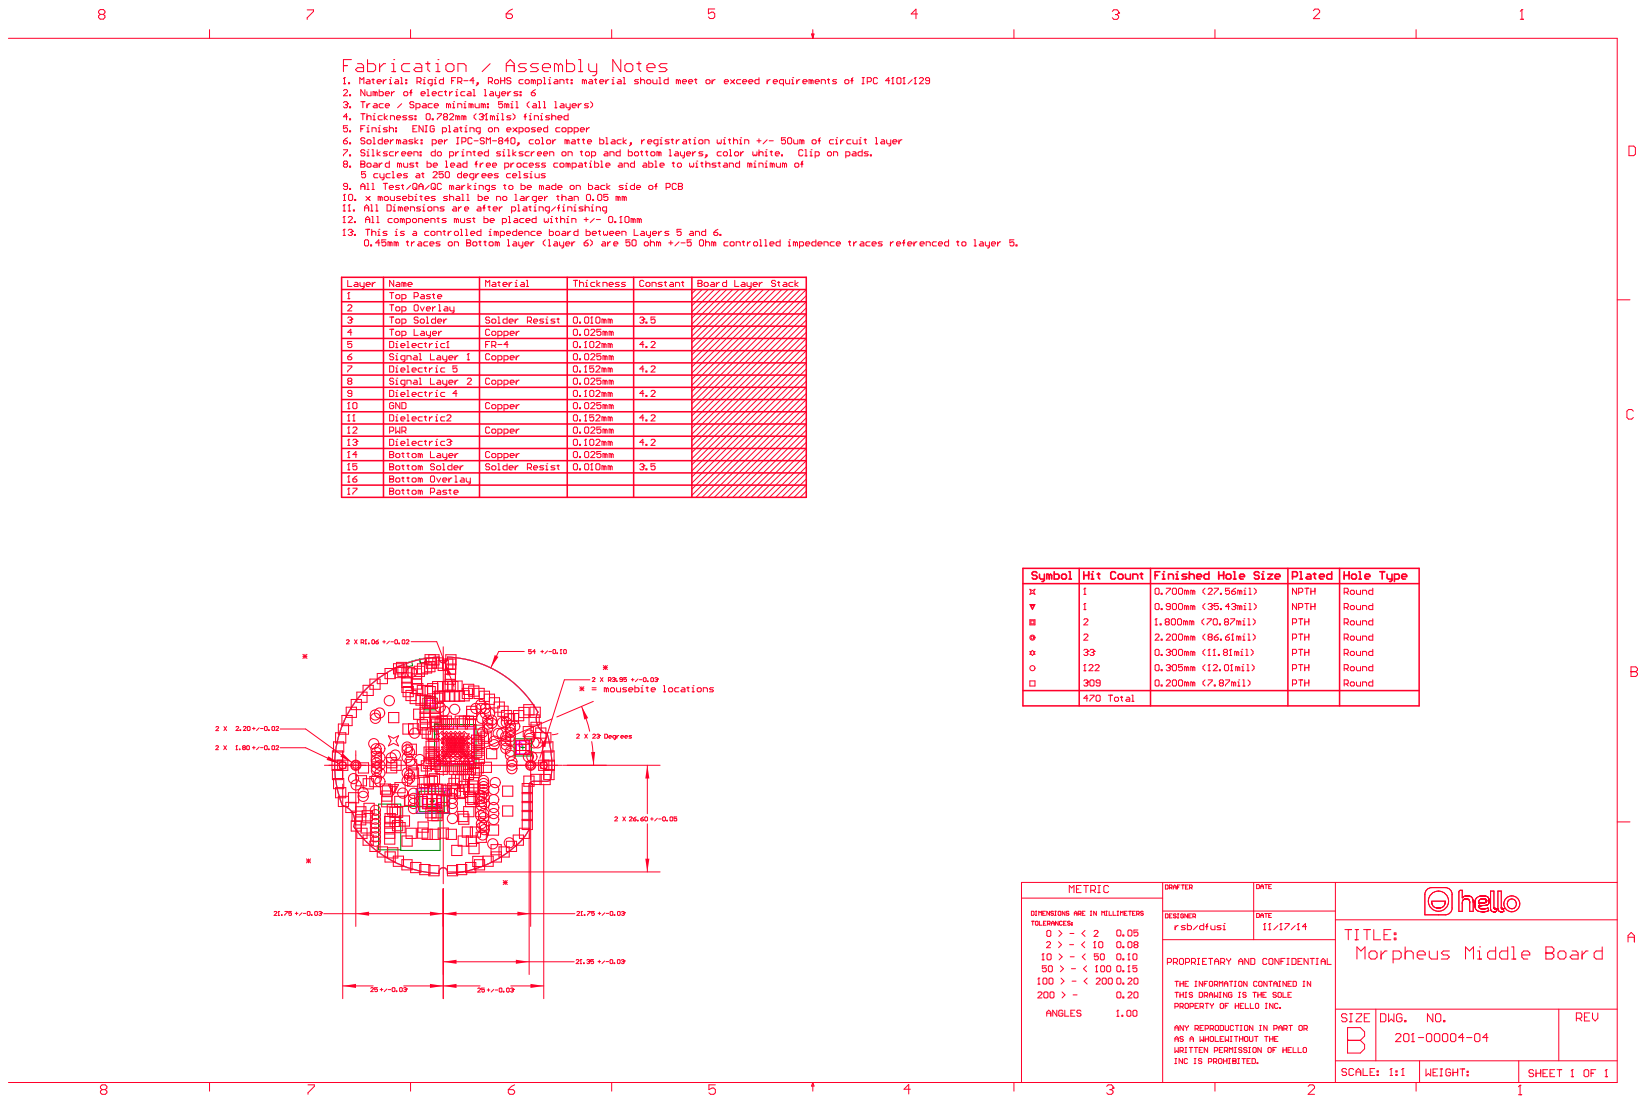
[picture p40: page 9]

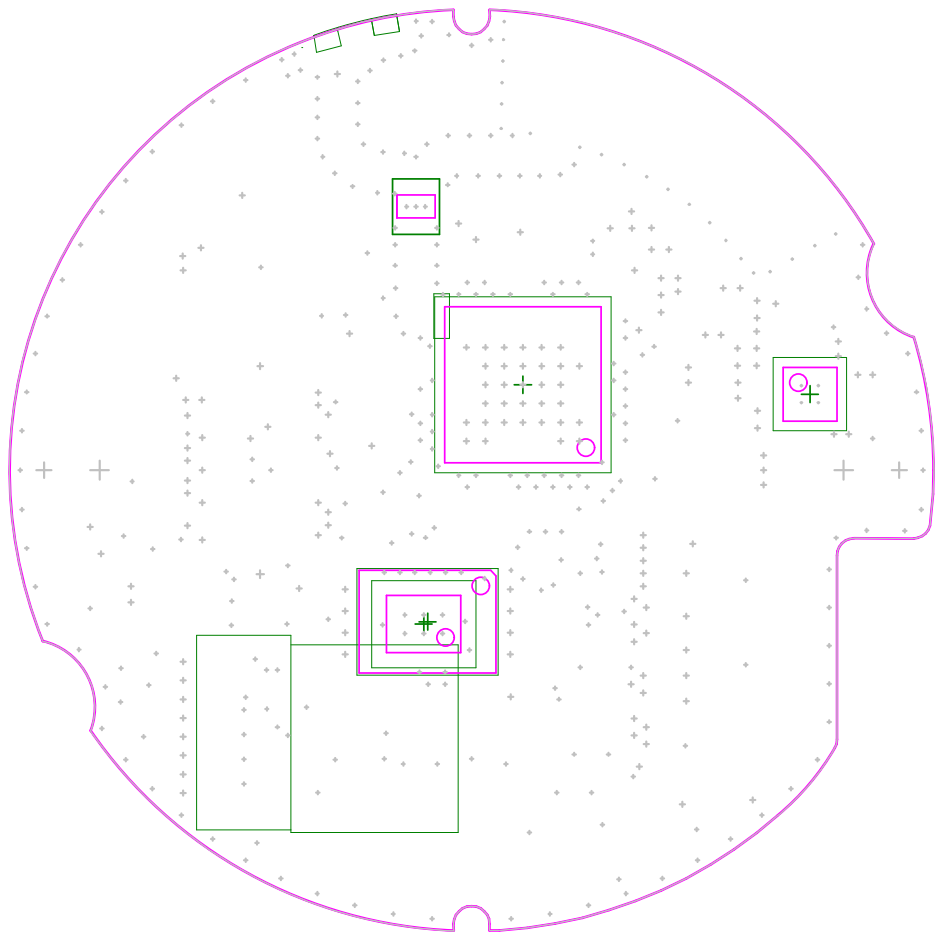
[picture p41: page 10]
