hello/morpheus-board-middle/Morpheus_middle/Morpheus_middle_DVT_release_candidate_111714_assy_drawing.PDF

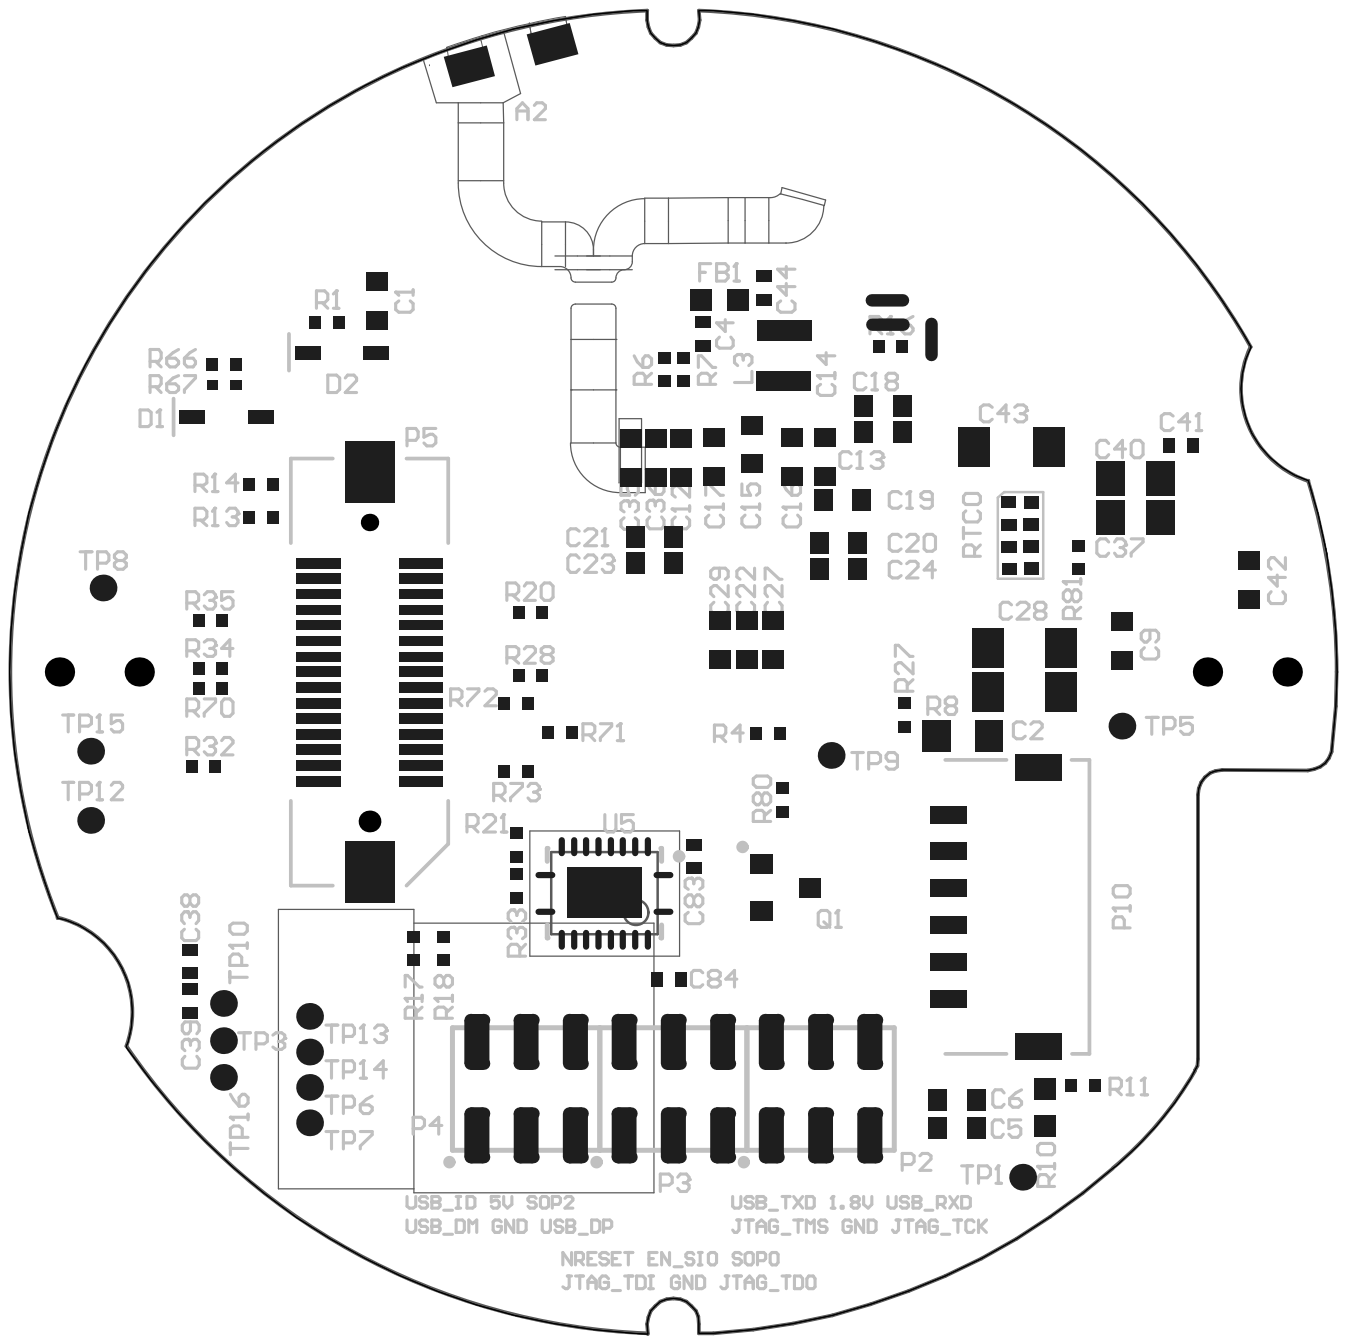
[picture p42: page 1]

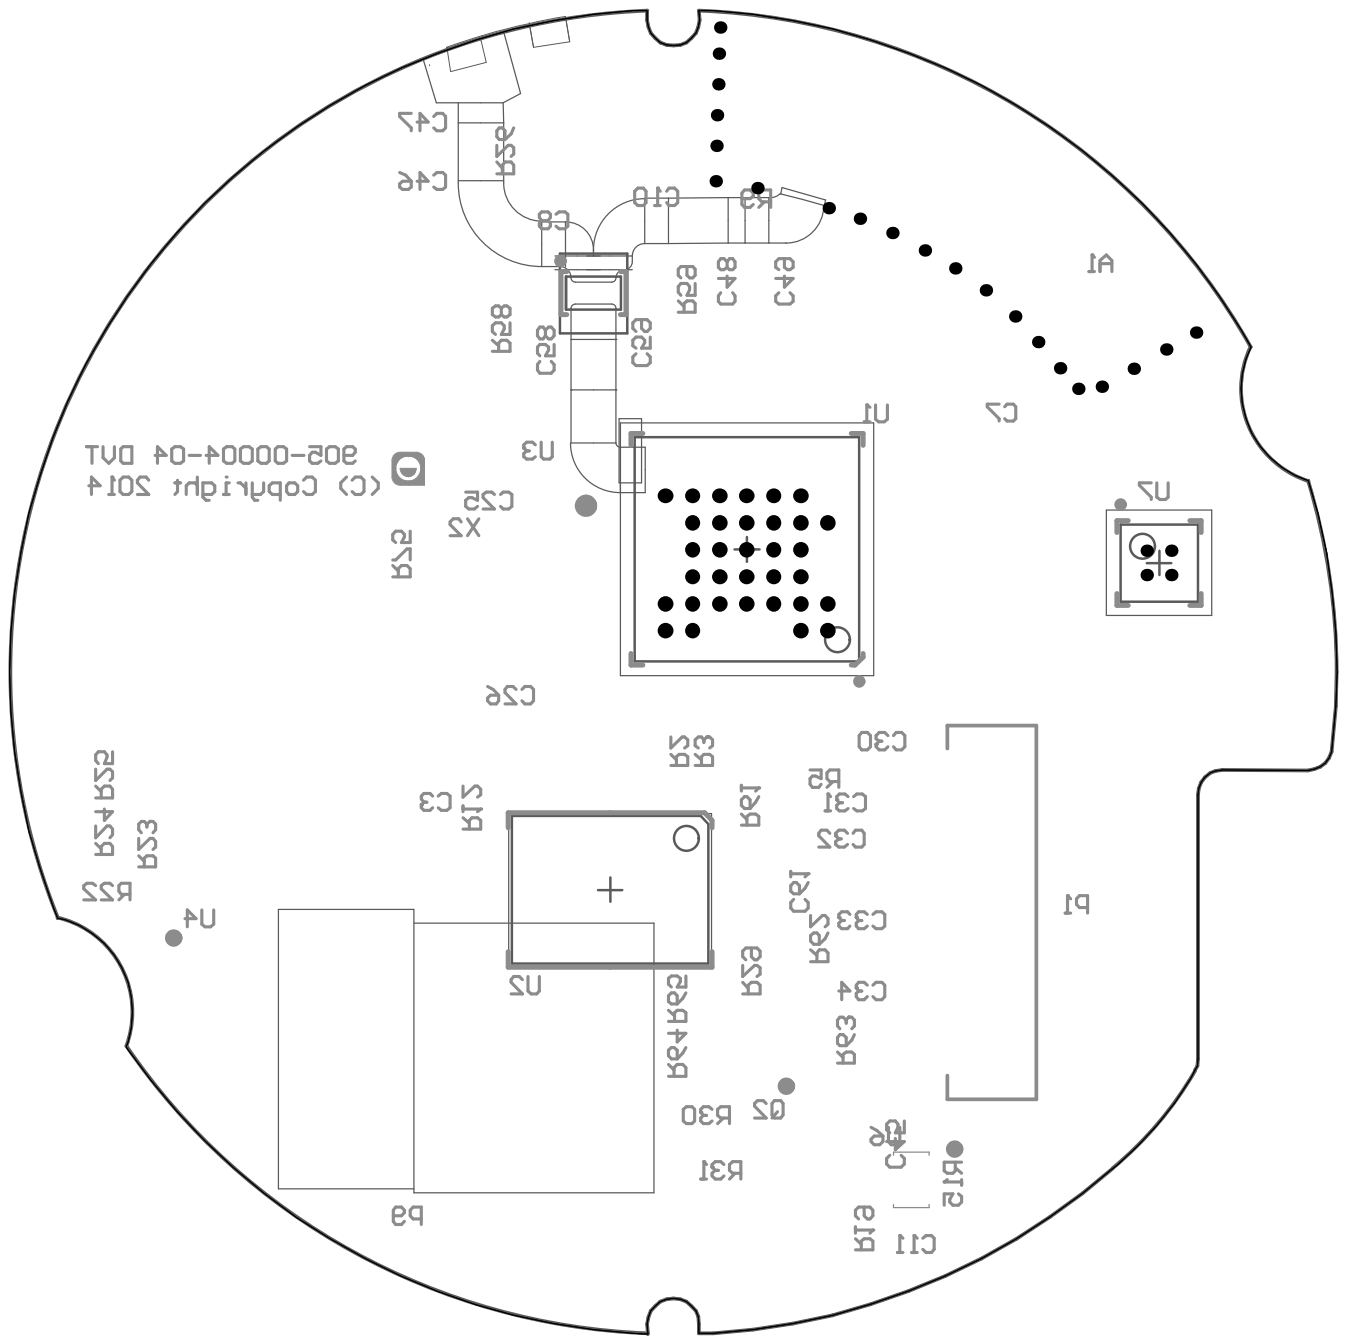
[picture p43: page 2]

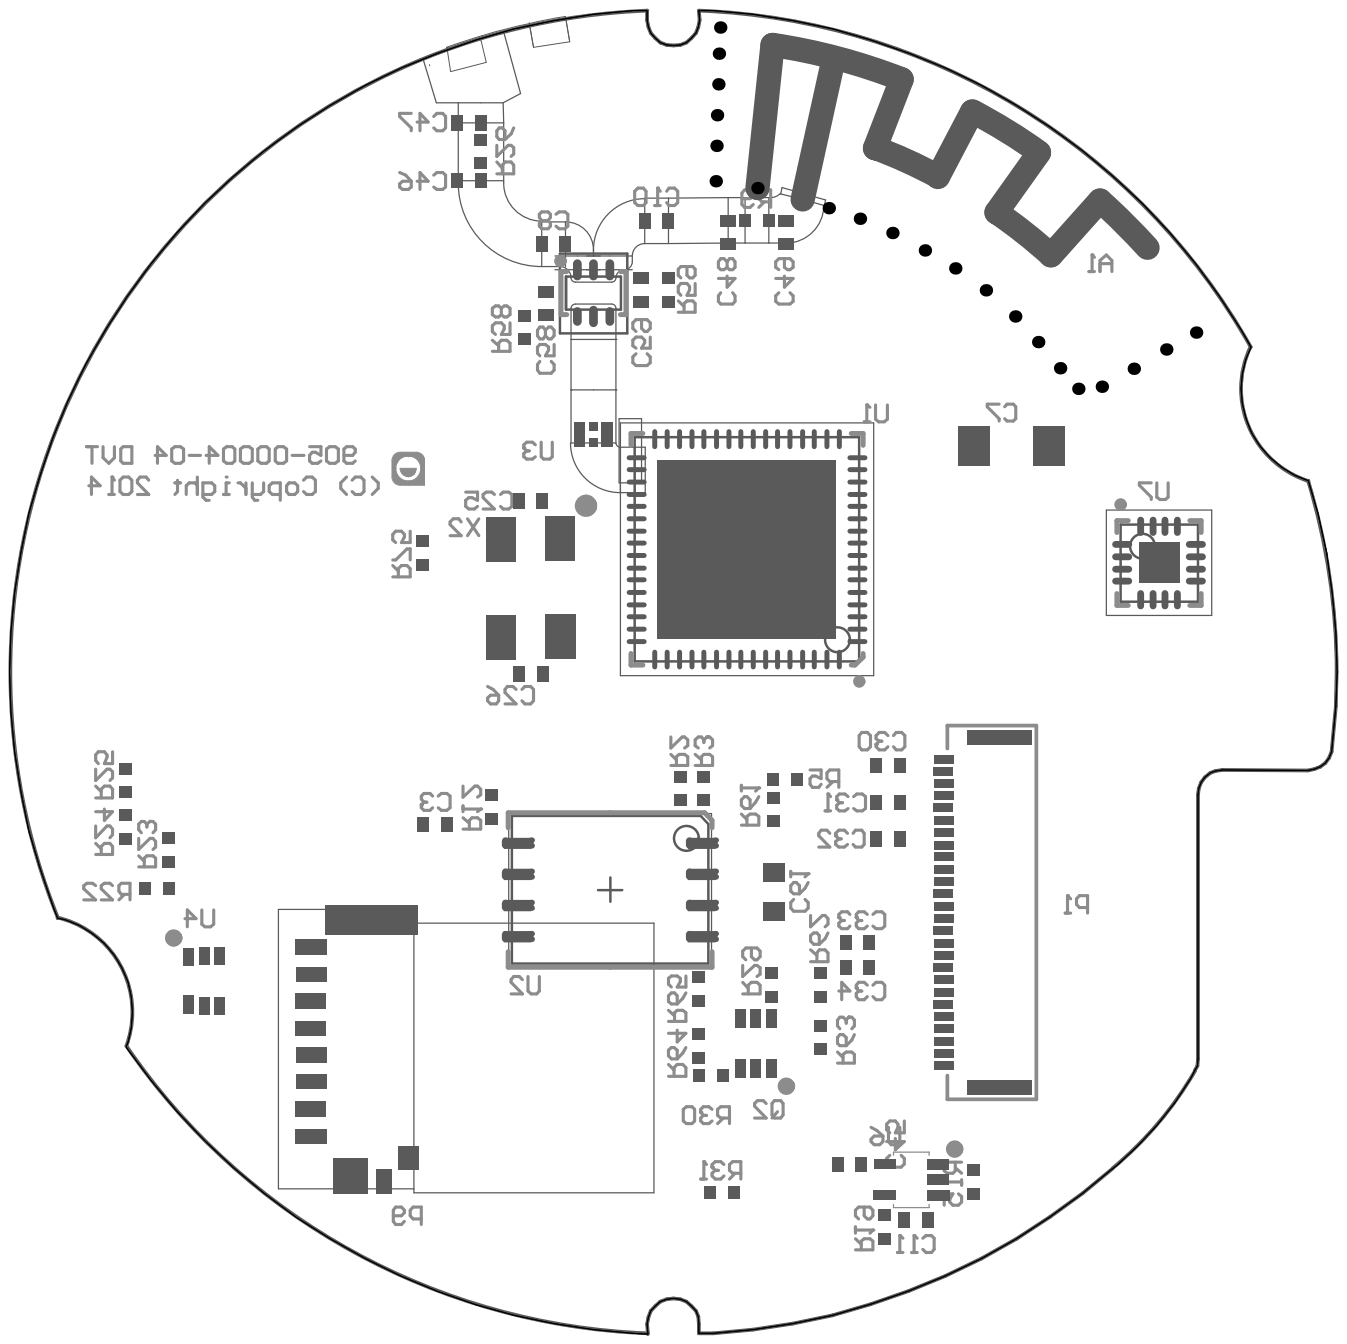
[picture p44: page 6]
