hello/morpheus-board-middle/(list of files, drawings)

Other design files:
Morpheus_middle/Air_quality.SchDoc
Morpheus_middle/Flash.SchDoc
Morpheus_middle/M4F_MCU.SchDoc
Morpheus_middle/M4F_MCU_Antennas.SchDoc
Morpheus_middle/M4F_MCU_Power.SchDoc
Morpheus_middle/Morpheus_middle.PcbDoc
Morpheus_middle/Morpheus_middle.PrjPcb
Morpheus_middle/Morpheus_middle.SchDoc
Morpheus_middle/SD_Card.SchDoc
