hello/morpheus-board-middle/(commit log)

2014-06-07 Big cleanup
    [40mm board.DXF, ADC Reference voltage.SchDoc, ADC.SchDoc, ADC1.SchDoc, ADC2.SchDoc, ADC3.SchDoc, ADC4.SchDoc, ADC5.SchDoc]
2014-07-01 cleaning up and starting layout for EVT1B
    [905-00004.DXF, Air_quality.SchDoc, Flash.SchDoc, M4F_MCU.SchDoc, M4F_MCU_Antennas.SchDoc, M4F_MCU_Power.SchDoc, Morpheus_middle.DWG, Morpheus_middle.PcbDoc]
2014-07-04 latest changes with new pinout from Chris. starting new layout for antennas
    [Flash.SchDoc, M4F_MCU.SchDoc, M4F_MCU_Antennas.SchDoc, M4F_MCU_Power.SchDoc, Morpheus_middle.PcbDoc, Morpheus_middle.SchDoc]
2014-07-24 layout updated, but will change again with breakout board and new CC3200 pin assignement
    [Air_quality.SchDoc, Flash.SchDoc, M4F_MCU.SchDoc, M4F_MCU_Antennas.SchDoc, M4F_MCU_Power.SchDoc, Morpheus_middle.PcbDoc, Morpheus_middle.PrjPcb, Morpheus_middle.SchDoc]
2014-07-30 minor cleanup, still need to add 2 flash memories
    [Flash.SchDoc, M4F_MCU.SchDoc, Morpheus_middle.DWG, Morpheus_middle.PcbDoc, Morpheus_middle.PrjPcb, Morpheus_middle.SchDoc]
2014-08-21 update from dyke. danny picks up from here and continues layout
    [Air_quality.SchDoc, Flash.SchDoc, M4F_MCU.SchDoc, M4F_MCU_Antennas.SchDoc, M4F_MCU_Power.SchDoc, Morpheus_bottom_flex.PcbDoc, Morpheus_middle.PcbDoc, Morpheus_middle.SchDoc]
2014-08-29 rf layout to be done, the rest is up for review
    added sd card connector 3d body
    [Air_quality.SchDoc, Flash.SchDoc, M4F_MCU.SchDoc, M4F_MCU_Antennas.SchDoc, M4F_MCU_Power.SchDoc, Morpheus_middle.PcbDoc, Morpheus_middle.PrjPcb, Morpheus_middle.SchDoc]
2014-08-29 latest version for bryan,. schematic done, layout on its way
    [M4F_MCU.SchDoc, Morpheus_middle.PcbDoc, Morpheus_middle.PrjPcb, Morpheus_middle.SchDoc, SD_Card.SchDoc]
2014-09-04 changes from Bill integrated in layout
    [Air_quality.SchDoc, Flash.SchDoc, M4F_MCU.SchDoc, M4F_MCU_Antennas.SchDoc, M4F_MCU_Power.SchDoc, Morpheus_bottom_flex.PcbDoc, Morpheus_middle.PcbDoc, Morpheus_middle.PrjPcb]
2014-09-05 EVT2 released to fab
    [M4F_MCU.SchDoc, Morpheus_middle.DWG, Morpheus_middle.PcbDoc, Morpheus_middle.SchDoc, SD_Card.SchDoc, Top Board DXF for Danny.DXF]
2014-09-05 actual EVT2 with updates to bottom silkscreen
    [Morpheus_middle.PcbDoc, Morpheus_middle.PrjPcb, Morpheus_middle.SchDoc]
2014-09-10 R62-65 changed in value for 2R-R network on USB lines
    [M4F_MCU.SchDoc, Morpheus_middle.PrjPcb]
2014-10-16 going back to EVT2 layout and turn it into a 6-layer
    [Air_quality.SchDoc, Flash.SchDoc, M4F_MCU.SchDoc, M4F_MCU_Antennas.SchDoc, M4F_MCU_Power.SchDoc, Morpheus_middle.PcbDoc, Morpheus_middle.PrjPcb, Morpheus_middle.SchDoc]
2014-10-28 big update before reviewing DVT
    [Air_quality.SchDoc, Flash.SchDoc, M4F_MCU.SchDoc, M4F_MCU_Antennas.SchDoc, M4F_MCU_Power.SchDoc, Morpheus_middle.PcbDoc, Morpheus_middle.PrjPcb, Morpheus_middle.SchDoc]
2014-11-20 DVT Release of Morpheus Middle Board on 11/17/2014
    DVT Release of Morpheus Middle Board (905-00005-04) on 11/17/2014.
    This release was sent to Jabil for the DVT build.
    [54mm Board.DXF, 905-00004-04-DVTd.DWG, 905-00004.DXF, Air_quality.SchDoc, Flash.SchDoc, M4F_MCU.SchDoc, M4F_MCU_Antennas.SchDoc, M4F_MCU_Power.SchDoc]
2014-11-21 DVT Release of Morpheus Middle Board on 11/17/2014
    DVT Release of Morpheus Middle Board (905-00004-04) on 11/17/2014.
    (deleted an old archive in order to fix the error in the previous
    commit message)
    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
2015-01-10 PVT Release of Morpheus Middle Board on 12/30/2014
    PVT Release of Morpheus Middle Board (905-00004-05) on 12/30/2014.
    This release was sent to Jabil for the PVT/MP build.
    Mid
    - Add 4 vias each to IFA antenna pads to mechanically secure the pads
    to the board. (MFG Yield Issue).
    - Update footprint for U5 to closely match TI's recommendations and
    improve MFG yield. (MFG Yield Issue).
    - Close solder paste mask openings on BOB connector (Test Yield Issue)
    - Add testpoint for Dust Sensor (Improve Test Yield / resolve coverage
    issue)
    - Update FAB drawing location for mousebites (From DVT EQs)
    - Roll in BOM change for Q2 (From ECO20141209-0001)
    - Change PN in drawings and silk. (Update to match rev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
    [Air_quality.SchDoc, M4F_MCU.SchDoc, Morpheus_middle.PcbDoc, Morpheus_middle.PrjPcb]
2015-06-29 Mass production version (1/15)
    Mass production version
    [Morpheus_middle.PcbDoc, Morpheus_middle.PrjPcb]
2015-06-29 Cost reduction NPI build
    Hello PN updated in library
    [Air_quality.SchDoc, Flash.SchDoc, M4F_MCU.SchDoc, M4F_MCU_Antennas.SchDoc, M4F_MCU_Power.SchDoc, Morpheus_middle.PrjPcb, Morpheus_middle.SchDoc, SD_Card.SchDoc]
